paulfaget/PlasmaArcSpeaker/Images/Gap in operation.JPG

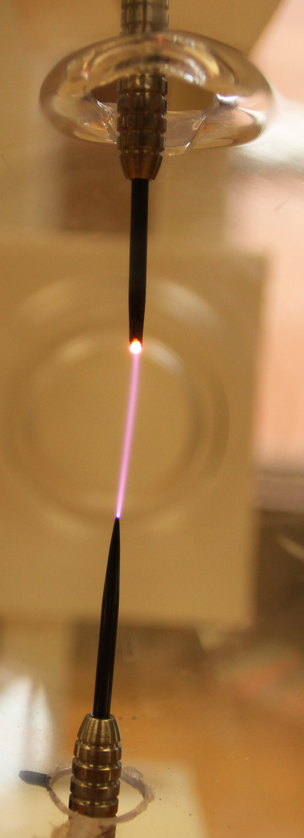
Images/Gap in operation.JPG
