paulfaget/PlasmaArcSpeaker/Images/Amplifier Innards_resized.jpg

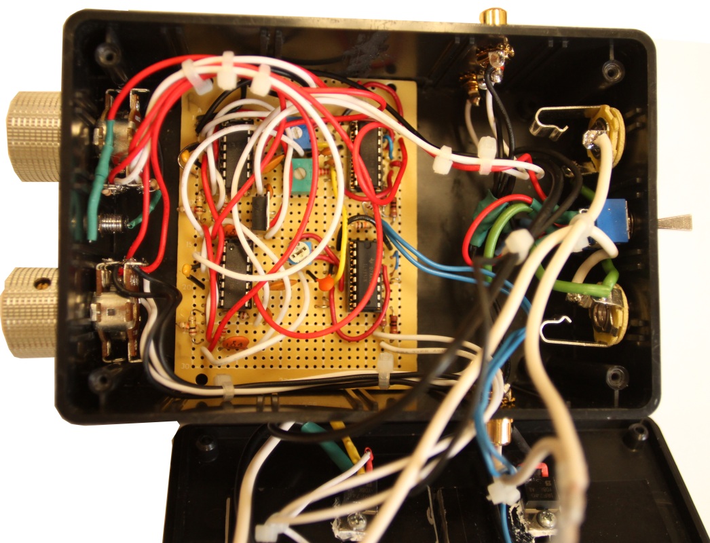
Images/Amplifier Innards_resized.jpg
