paulfaget/PlasmaArcSpeaker/Mechanical/pairwise (2).xlsx

Sheet: Work
PAS Pairwise Comparison
 |  | Safety | Operation Force (N) | Sound Level (dB) | Cost
CV 1 | Concept 1 | 2 | 15 | 65 | 75
CV 2 | Concept 2 | 4 | 15 | 80 | 80
CV 6 | Concept 3 | 1 | 10 | 60 | 60
CV 8 | Concept 4 | 4 | 5 | 65 | 70
Raw Score
 | Safety | Operation Force | Sound Level | Cost
Concept 1 | 0.333 | 0 | 0.25 | 0.75
Concept 2 | 1 | 0 | 1 | 0
Concept 3 | 0 | 0.5 | 0 | 1
Concept 4 | 1 | 1 | 0.25 | 0.5
Psuedo Variants
 | Sketch 1 | Sketch 2 | Sketch 3 | Sketch 4
Safety | 4 | 1 | 1 | 1
Operation Force (N) | 15 | 5 | 15 | 15
Sound Level (dB) | 60 | 60 | 80 | 60
Cost | 80 | 80 | 80 | 60
Pseudo 2 > 3 > 1 > 4
Comparing 2 and 3
Thus Psuedo 2 becomes A and Psuedo 3 becomes B
First equation will become Wsoundlvl = Y*Woperation force
Will increase A until both options A & B are equal. The value of A that makes A & B the same is 10 N.
Our x-axis values are 5, 10 and 15; |  | Our y-axis values are 0, Y, 1
After interpolation the equation becomes Wsoundlvl = 0.5*Woperation force
Comparing 3 and 1
The second equation will become Wsafety = Y*Wsoundlvl
Will decrease A until both options A & B are equal. The value of A that makes A & B the same is 70 dB.
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
