paulfaget/PlasmaArcSpeaker/Mechanical/Table.xlsx

Team PAS Plasma Arc Speaker Failure Modes
Failure Mode Primary Identifier | Failure Mode | Likelihood | Consequence Rating | Description
Creep | Stress Rupture | 3 | 5 | The arms holding the top and bottom electrodes could break in two as a result of stress from the electrode weight and temperature changes within the speaker housing.
Fatigue | Surface Fatigue | 3 | 4 | The rack and pinion used to raise and lower the electrodes could experience cyclical fatigue and fail over time.
Fretting | Thermal Fatigue | 1 | 4 | Temperature changes, ranging from hot when the speaker is on to cold when the speaker is off, could cause failure in the mechanical device used to raise and lower the electrodes.
Rupture | Brittle Fracture | 3 | 5 | The arms holding the top and bottom electrodes could break in two due to the electrode weight.
Spalling | Spalling | 1 | 3 | Particles could break loose in the rack and pinion housing, interupting the smooth operation of the rack and pinion.
Wear | Surface Fatigue Wear | 2 | 4 | Wear could cause failure in the rack and pinion, as well as more spalling.
Breakdown | Glow Discharge | 4 | 2 | Electrodes could heat up and glow, causing the metal to melt and/or vaporize.
Noise | Electric Field Coupling | 3 | 4 | Electric fields created by the high voltage of the plasma arc could cause interference with electrical devices.
Noise | Electromagnetic Radiation | 3 | 4 | The plasma arc operates at high frequencies, causing interference with electrical devices.
Noise | Ground Bounce | 1 | 2 | Poor ground connections could result in interference with electrical devices.
Overstress or Incorrect Current Magnitude | Electrical Overstress (EOS) | 2 | 2 | A higher current could be produced, creating more heat on the electrodes and raising the potential for the electrodes to melt and/or vaporize.
