paulfaget/PlasmaArcSpeaker/Mechanical/Concept Sketches.pdf

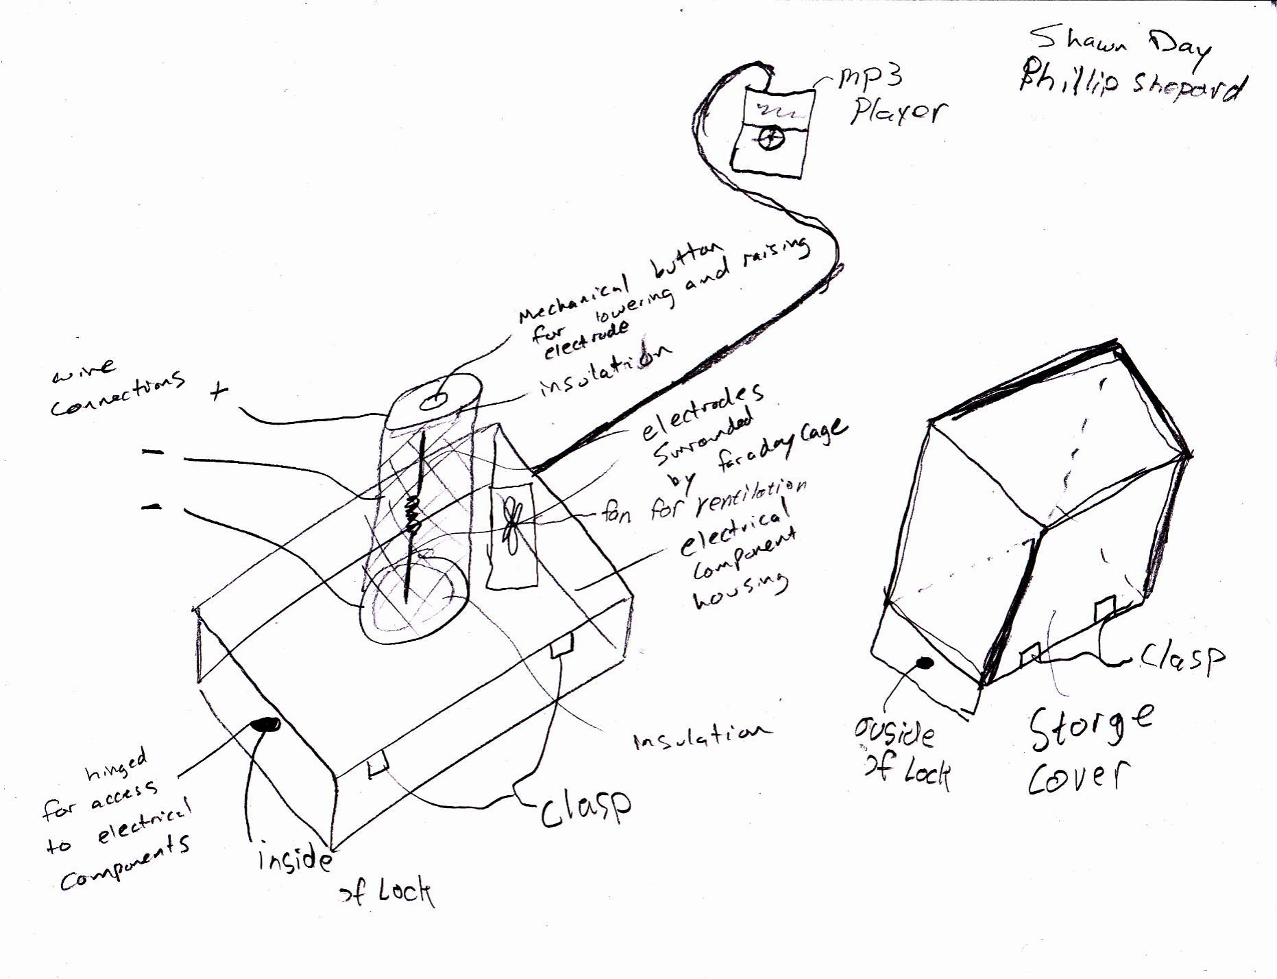
[picture p13: page 1]

IhP3
PLror

Sho-^ f;o.,
9A,l+'p sl,"p!,r/

'. .*sr r.i
-, -\ 'l o^t
g:cts^',lrre' '"1
W-

vts J ' t

\,.9,tq+iaA
V', *5'A
.c.
P6 o&'.)rJ
+e e\cu'.nl s
C""qn' | ir,qide\
7{ Loc\

6\aSp

# gin'K,**

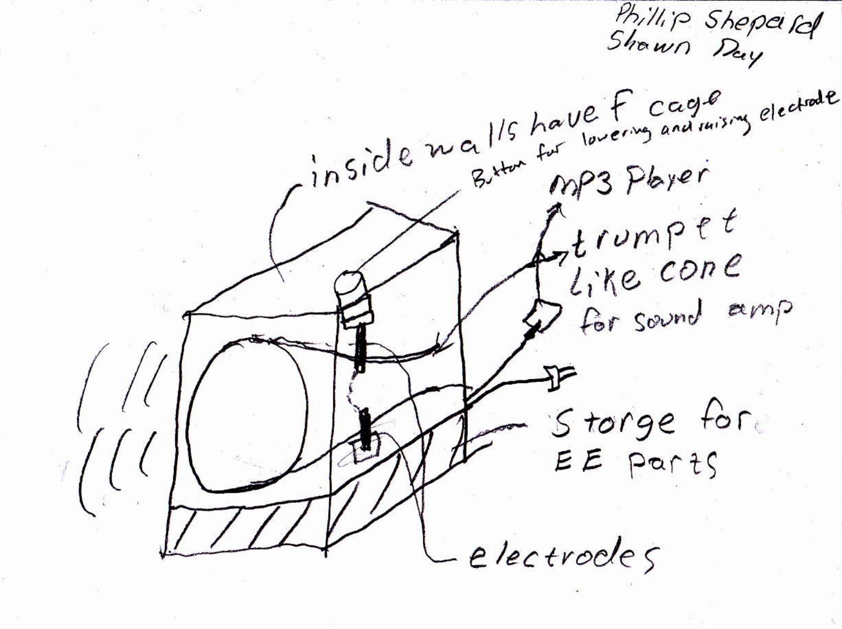
[picture p14: page 2]

e ( c*?o.,^ epcr')a
r .,'cl u * ^-l',i-Yu?*)';;*"'"' V
wwnW3 PbYn' in5'
+ t,trnP (

t
i;rru ,r,
e
&r se,roJ on{)

[//
'(t

,

g turge A r,
E E portg

g lec+roe)e
g

# ffi^nYr

c;;e#"'

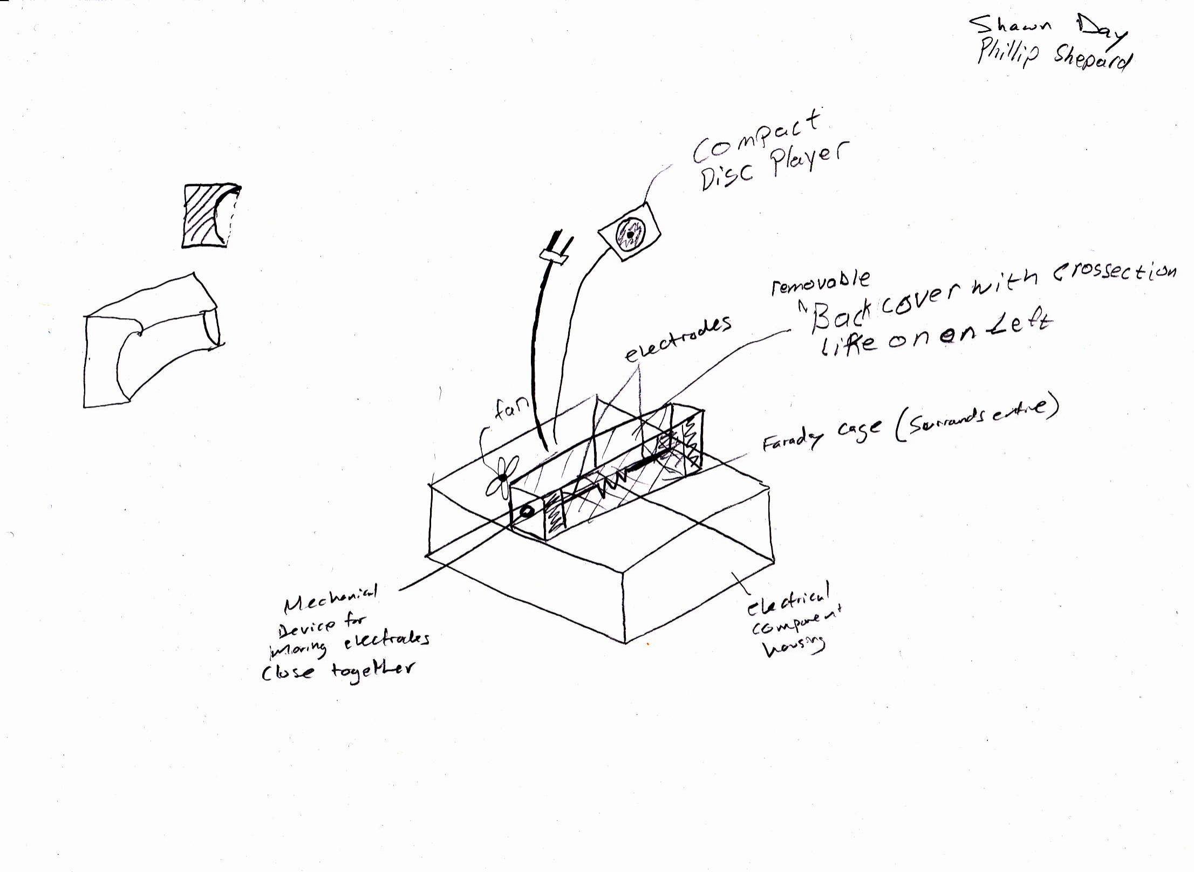
[picture p15: page 3]

l) etv'n:nl ''
tr::;7"+*'

# WI;'*"1!", \i{"'J' an te!*

## r"-)Y ^5' (9"-)'"*c)

## 'rYI:\

rc(evoEle

\A*t)

, p4 ( loskc t i,tu

Clos-e' \el4+r

## ll;/t;p shepa rel

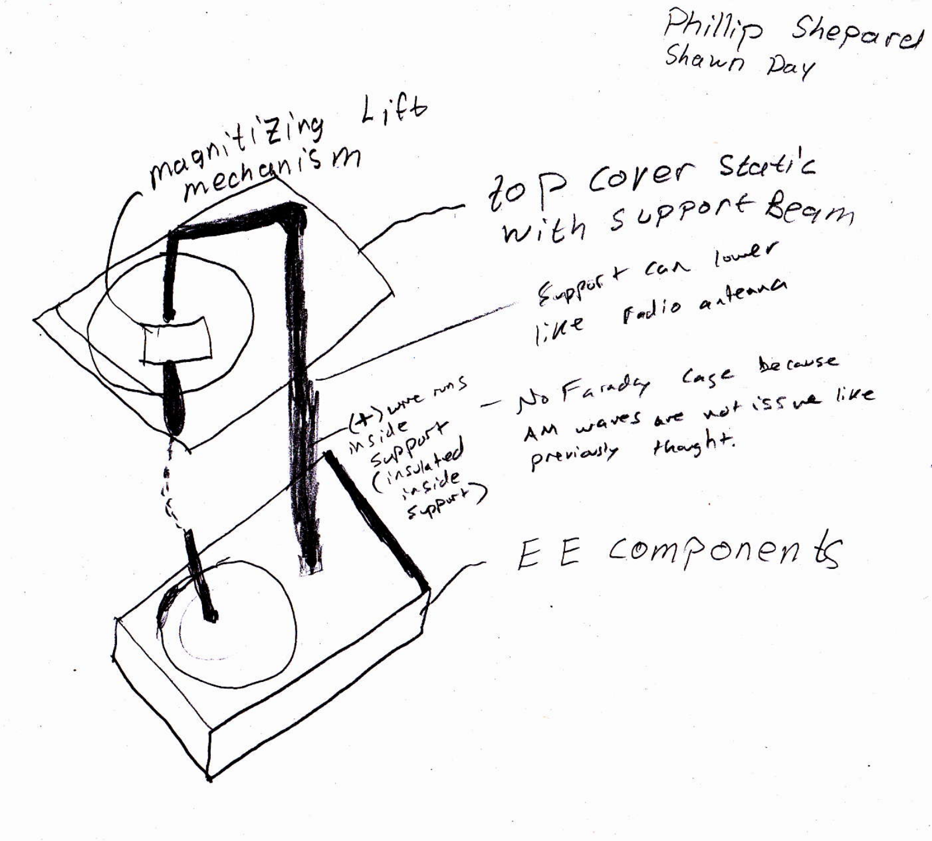
[picture p16: page 4]

>aau,p *ry
L iQb .+ i7 in9 {}ri'* | Cofet^ Stalr2 toP S uP?Dr( E€q*,

### w ith

(;:.

""^')

b,..2/
,.N*o

*)o (o'-l?
I r.rr *ra Jf,J
g *viatlt/

ttga
ae #l
rn*\*.

6c t"us<'
is< r^t lilc

a
c
(\
E E .om?onen k
