paulfaget/PlasmaArcSpeaker/Mechanical/Decision_Matrix_Example.xls

Sheet: Template_DM
PAS Decision Matrix
 | How important are these evaluation criteria? |  |  |  | How good are these concepts?
 | 5: Extremely Important |  |  |  | 5: Very Good
 | 4: Very Important |  |  |  | 4: Good
 | 3: Important |  |  |  | 3: Moderate
 | 2: Moderately Important |  |  |  | 2: Satisfactory
 | 1: Least Important |  |  |  | 1: Acceptable
 | 0: Not Important |  |  |  | 0: Out of concern
 | Objective | Target Value | Importance |  | CV 1 (Figure 1) |  | CV 2 (Figure 2) |  | CV3 (Figure 3) |  | CV4 (Figure 4) |  | CV5 (Figure 5) |  | CV6 (Figure 6) |  | CV7 (Figure 7) |  | CV8 (Figure 8) |  | CV9 (Figure 9) |  | CV10 (Figure 10)
 | (Criteria) |  | (Weight) |  | Raw | Weighted | Raw | Weighted | Raw | Weighted | Raw | Weighted | Raw | Weighted | Raw | Weighted | Raw | Weighted | Raw | Weighted | Raw | Weighted | Raw | Weighted
 | Safe | No Able to be Shocked | 5 | 29.41176471% | 3 | 0.88 | 4 | 1.18 | 1 | 0.29 | 3 | 0.88 | 2 | 0.59 | 4 | 1.18 | 4 | 1.18 | 4 | 1.18 | 1 | 0.29 | 4 | 1.18
 | Easily Operated | Separate Electrodes up to 1.5" | 4 | 23.52941176% | 4 | 0.94 | 4 | 0.94 | 3 | 0.71 | 3 | 0.71 | 0 | 0.00 | 4 | 0.94 | 3 | 0.71 | 5 | 1.18 | 0 | 0.00 | 5 | 1.18
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
