paulfaget/PlasmaArcSpeaker/Images/Power Supply innards_resized.jpg

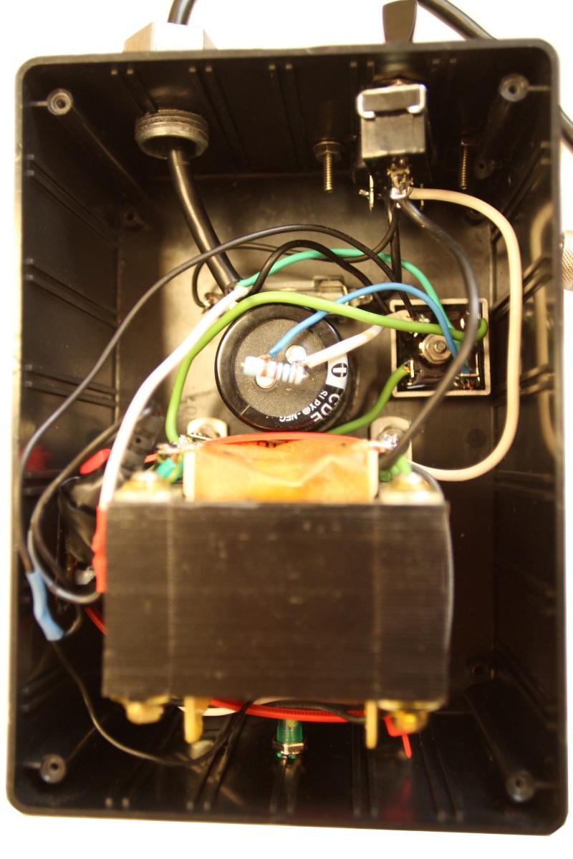
Images/Power Supply innards_resized.jpg
