paulfaget/PlasmaArcSpeaker/Schematics and Drawings/Crossover/Crossover BW.png

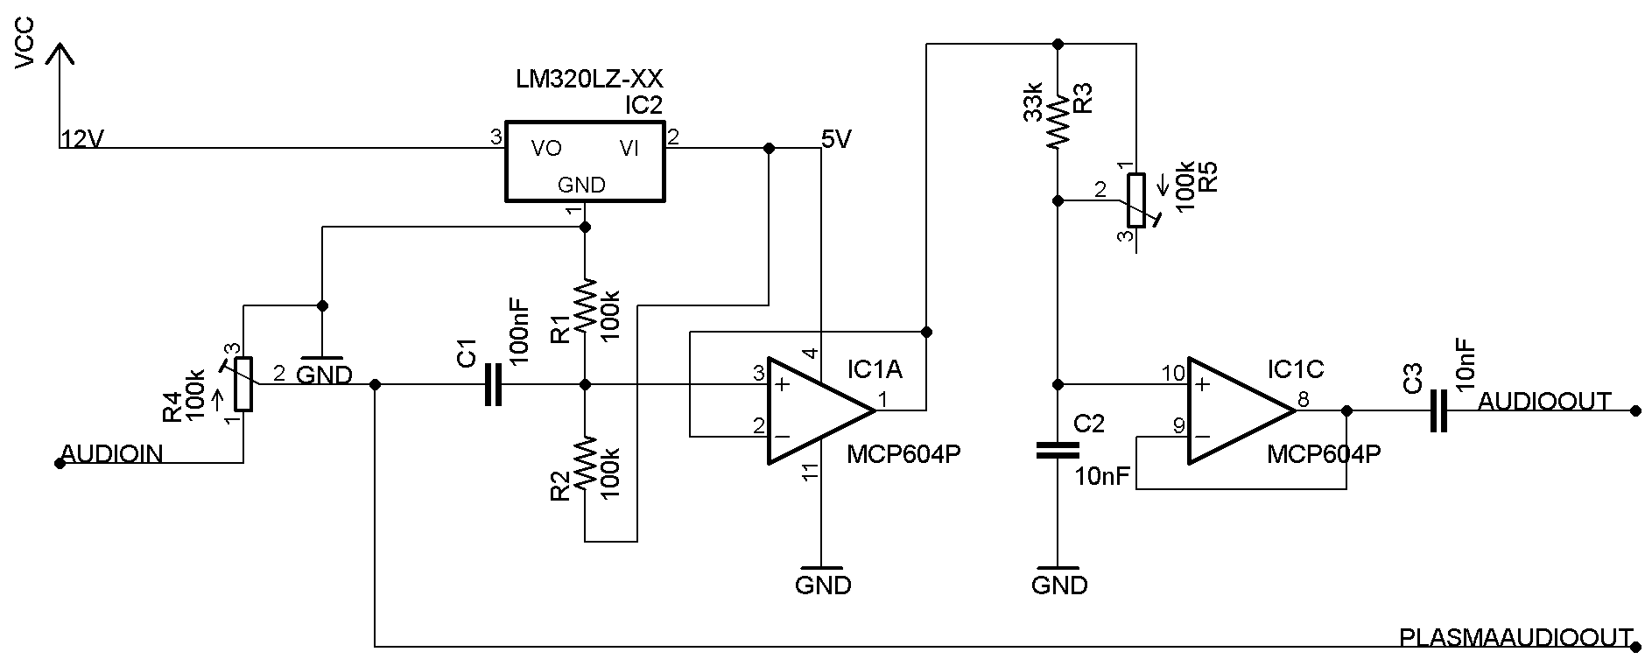
Schematics and Drawings/Crossover/Crossover BW.png
