paulfaget/PlasmaArcSpeaker/Schematics and Drawings/Crossover/Crossover.png

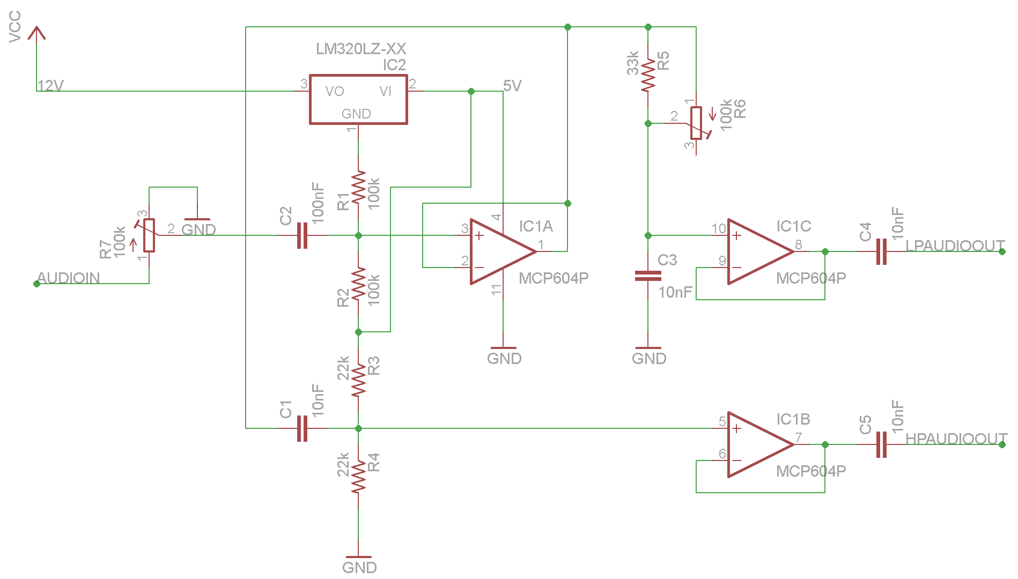
Schematics and Drawings/Crossover/Crossover.png
