paulfaget/PlasmaArcSpeaker/Schematics and Drawings/Mechanical/3D View.tif

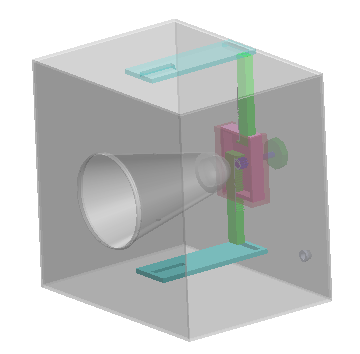
Schematics and Drawings/Mechanical/3D View.tif
