paulfaget/PlasmaArcSpeaker/Schematics and Drawings/Mechanical/Back View.tif

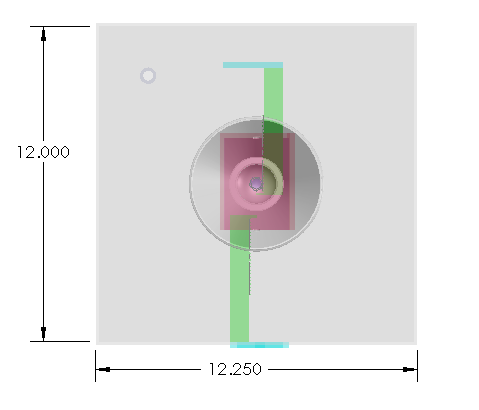
Schematics and Drawings/Mechanical/Back View.tif
