paulfaget/PlasmaArcSpeaker/Schematics and Drawings/Power Supply/Power Supply BW.png

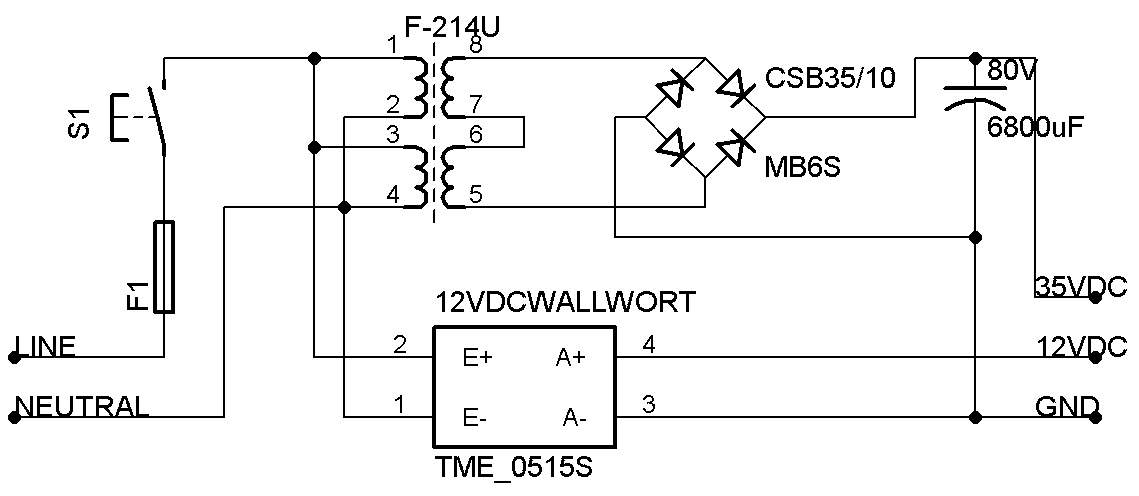
Schematics and Drawings/Power Supply/Power Supply BW.png
