paulfaget/PlasmaArcSpeaker/Schematics and Drawings/SDS/Rev1/SDS Block Diagram, Plasma Generator rev1.png

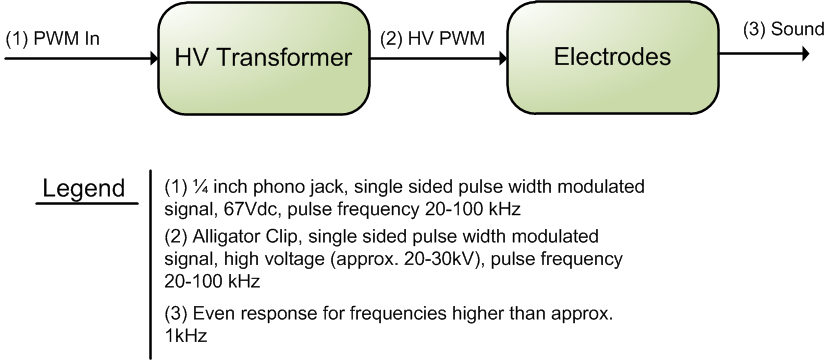
Schematics and Drawings/SDS/Rev1/SDS Block Diagram, Plasma Generator rev1.png
