paulfaget/PlasmaArcSpeaker/Schematics and Drawings/SDS/Rev1/SDS Block Diagram, Power Supply rev1.png

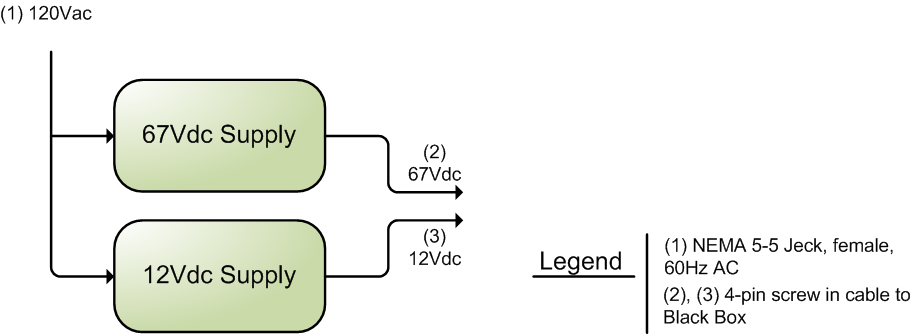
Schematics and Drawings/SDS/Rev1/SDS Block Diagram, Power Supply rev1.png
