paulfaget/PlasmaArcSpeaker/Schematics and Drawings/SDS/Rev1/SDS Block Diagram, Signal Processor rev1.png

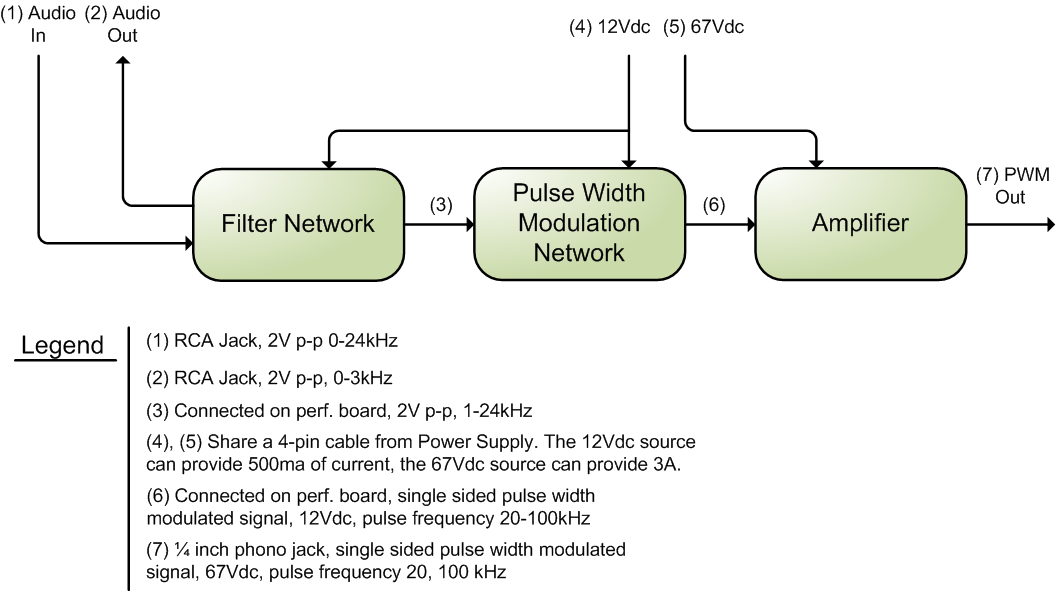
Schematics and Drawings/SDS/Rev1/SDS Block Diagram, Signal Processor rev1.png
