paulfaget/PlasmaArcSpeaker/Schematics and Drawings/SDS/Rev1/SDS Block Diagram, Whole System rev1.png

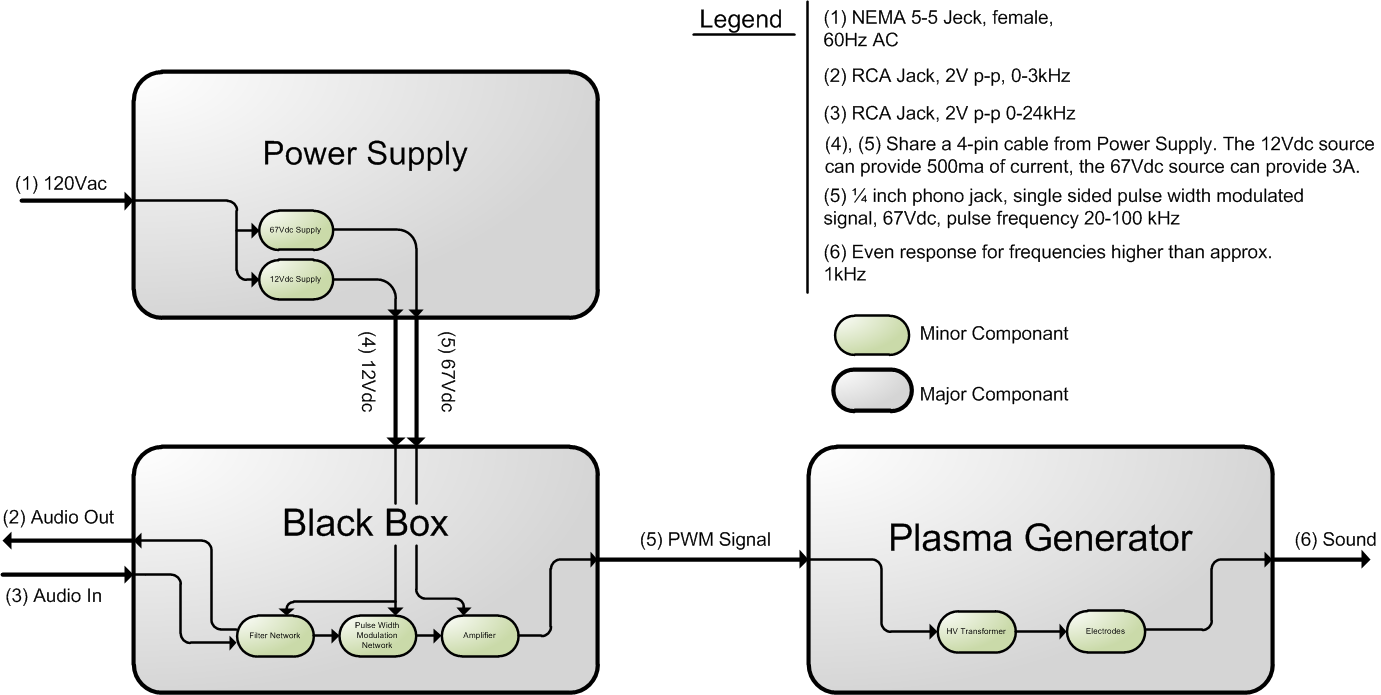
Schematics and Drawings/SDS/Rev1/SDS Block Diagram, Whole System rev1.png
