paulfaget/PlasmaArcSpeaker/Schematics and Drawings/SDS/SDS Block Diagram, Plasma Generator rev2.png

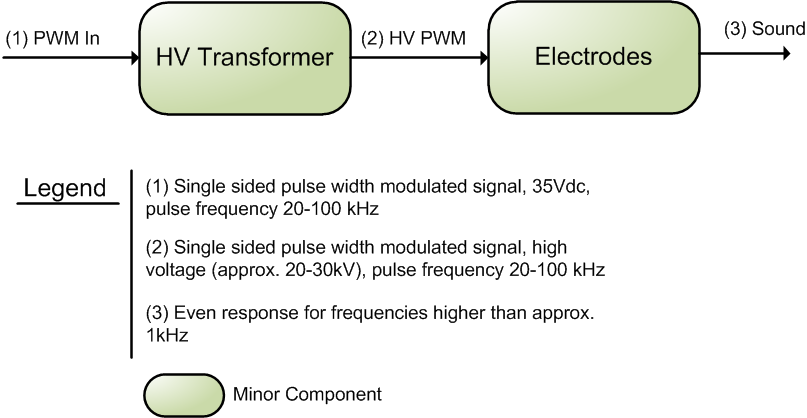
Schematics and Drawings/SDS/SDS Block Diagram, Plasma Generator rev2.png
