paulfaget/PlasmaArcSpeaker/Schematics and Drawings/SDS/SDS Block Diagram, Power Supply rev2.png

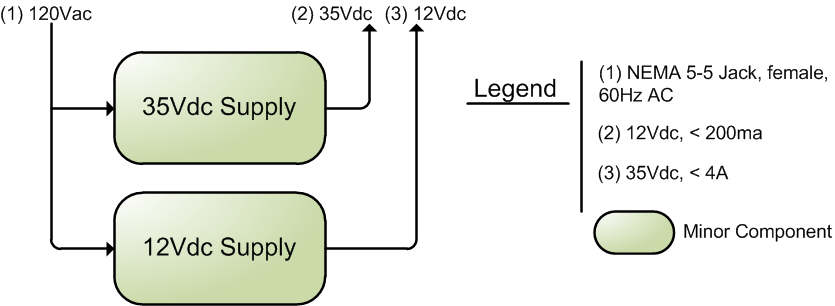
Schematics and Drawings/SDS/SDS Block Diagram, Power Supply rev2.png
