paulfaget/PlasmaArcSpeaker/Schematics and Drawings/SDS/SDS Block Diagram, Singal Processor rev2.png

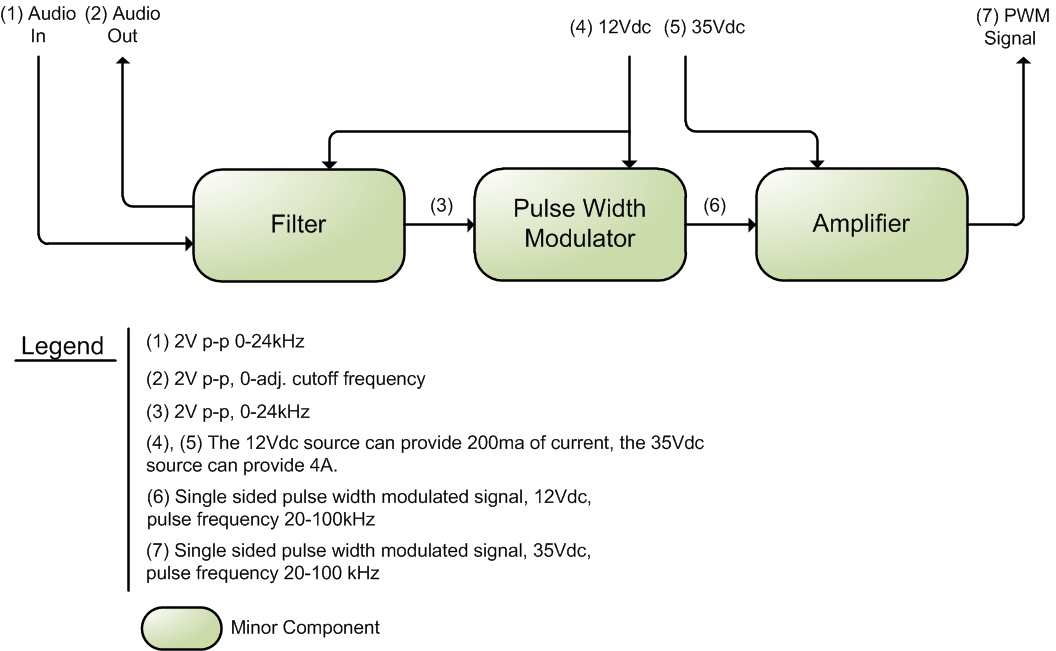
Schematics and Drawings/SDS/SDS Block Diagram, Singal Processor rev2.png
