paulfaget/PlasmaArcSpeaker/Schematics and Drawings/SDS/SDS Block Diagram, Whole System rev2.png

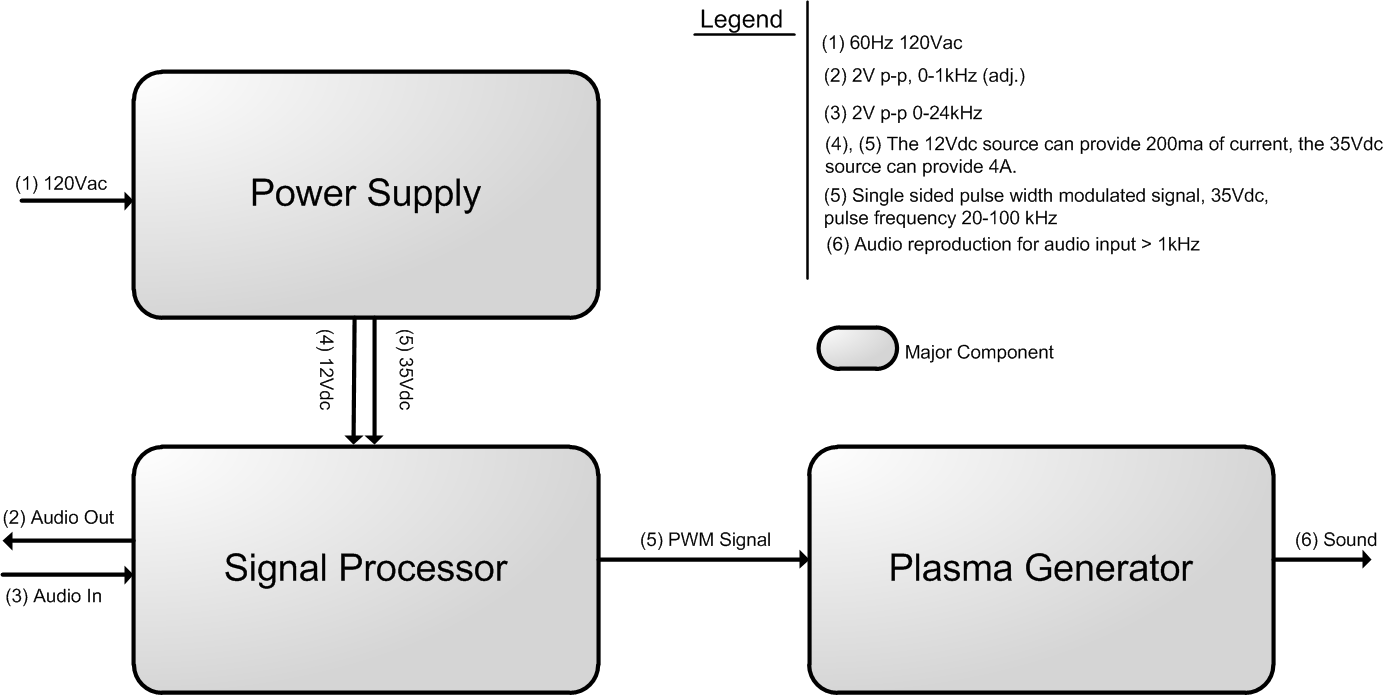
Schematics and Drawings/SDS/SDS Block Diagram, Whole System rev2.png
