paulfaget/PlasmaArcSpeaker/Schematics and Drawings/SDS/SDS Block Diagram, Whole System rev2a.png

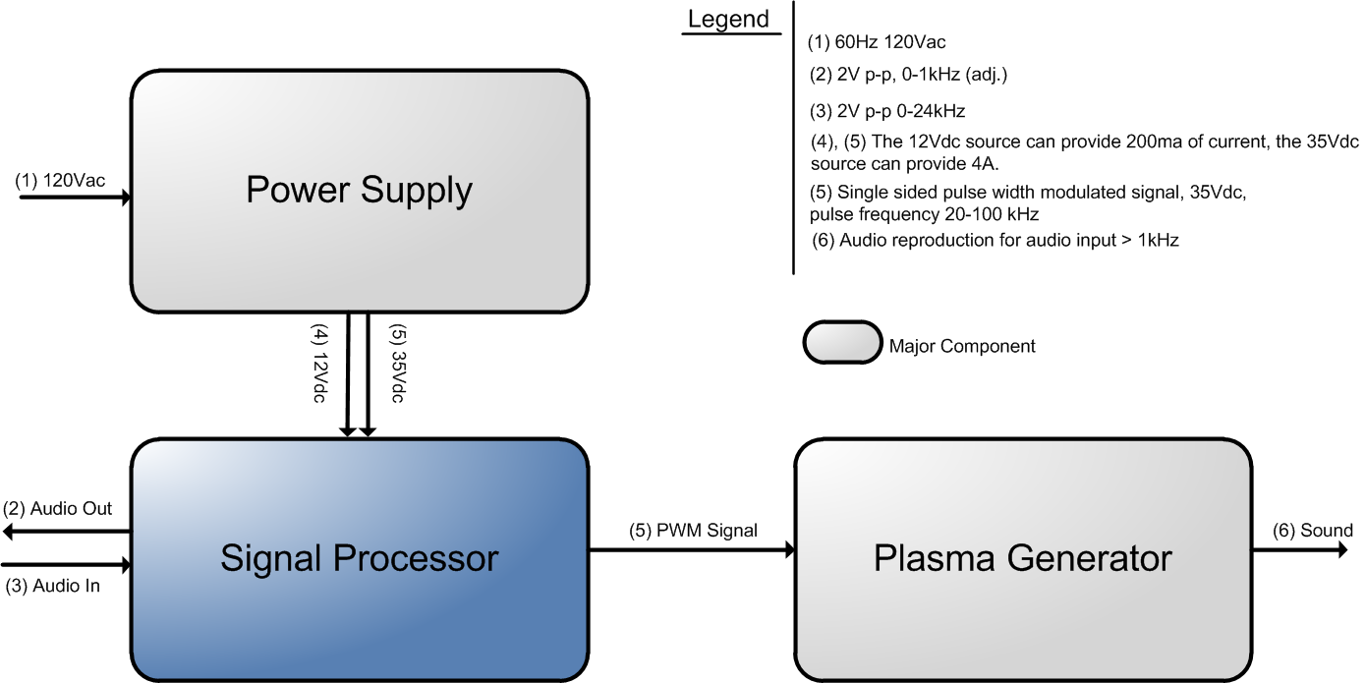
Schematics and Drawings/SDS/SDS Block Diagram, Whole System rev2a.png
