paulfaget/PlasmaArcSpeaker/Schematics and Drawings/Stereo Driver/Driver - Bridge Only BW.png

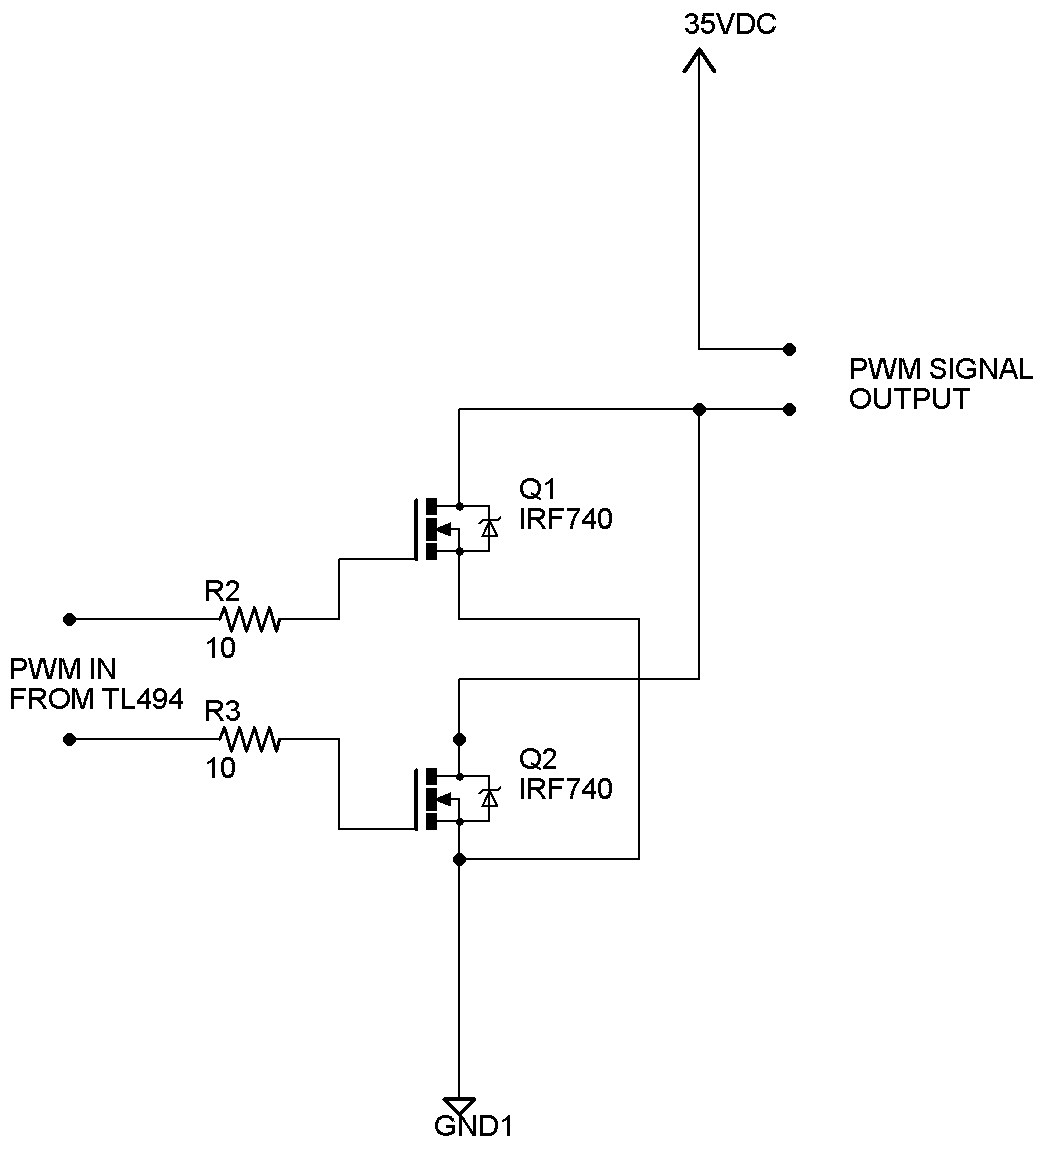
Schematics and Drawings/Stereo Driver/Driver - Bridge Only BW.png
