paulfaget/PlasmaArcSpeaker/Schematics and Drawings/Stereo Driver/Driver - Driver Only BW.png

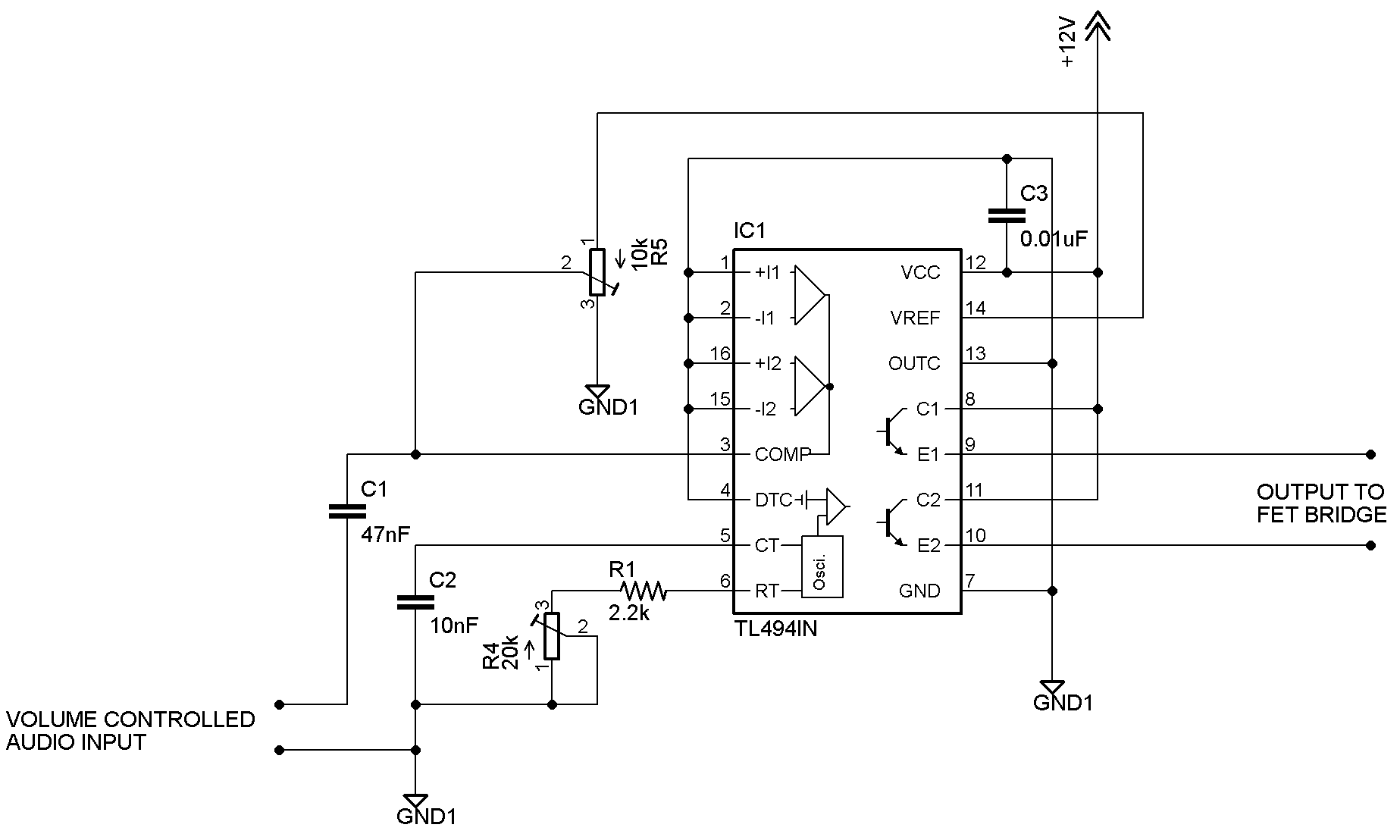
Schematics and Drawings/Stereo Driver/Driver - Driver Only BW.png
