paulfaget/PlasmaArcSpeaker/Schematics and Drawings/Stereo Driver/Driver - Single Channel BW.png

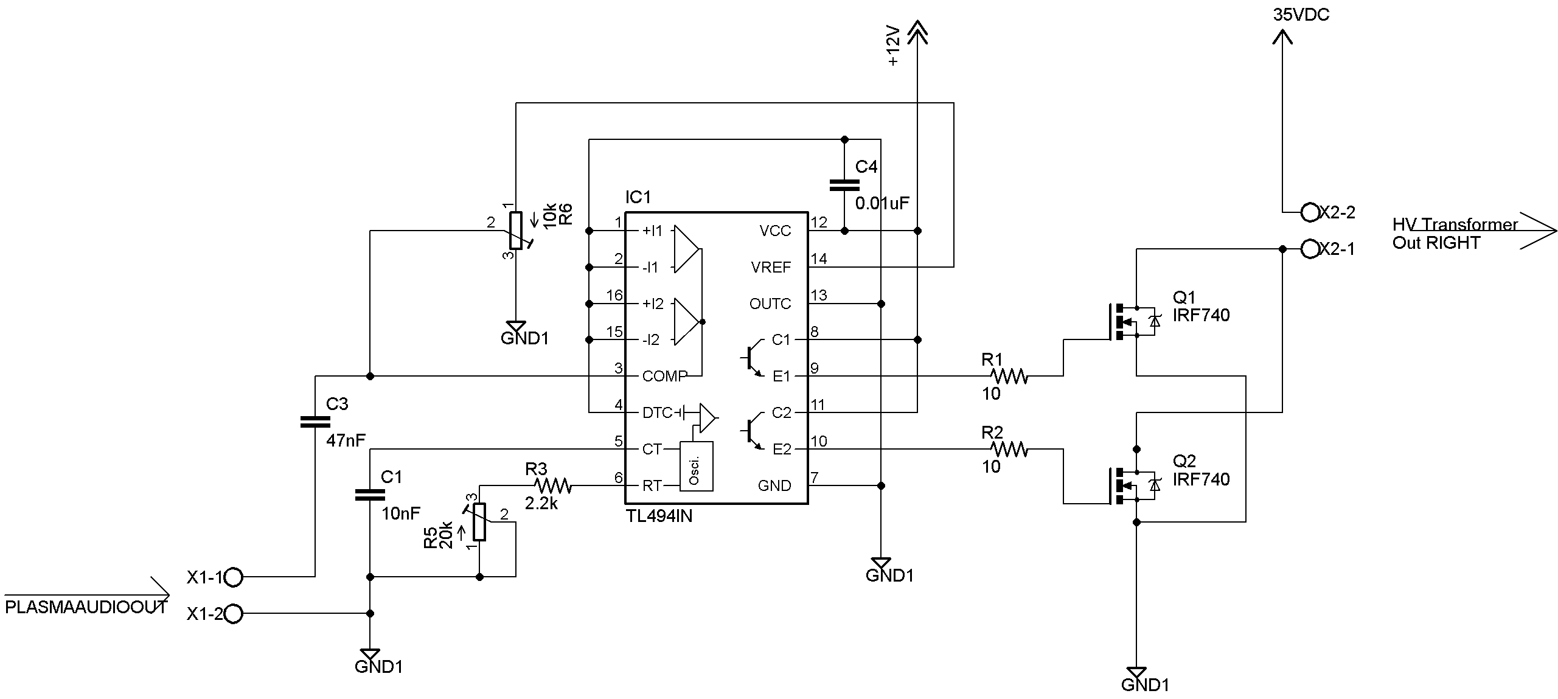
Schematics and Drawings/Stereo Driver/Driver - Single Channel BW.png
