paulfaget/PlasmaArcSpeaker/Schematics and Drawings/Stereo Driver/Driver - Single Channel.png

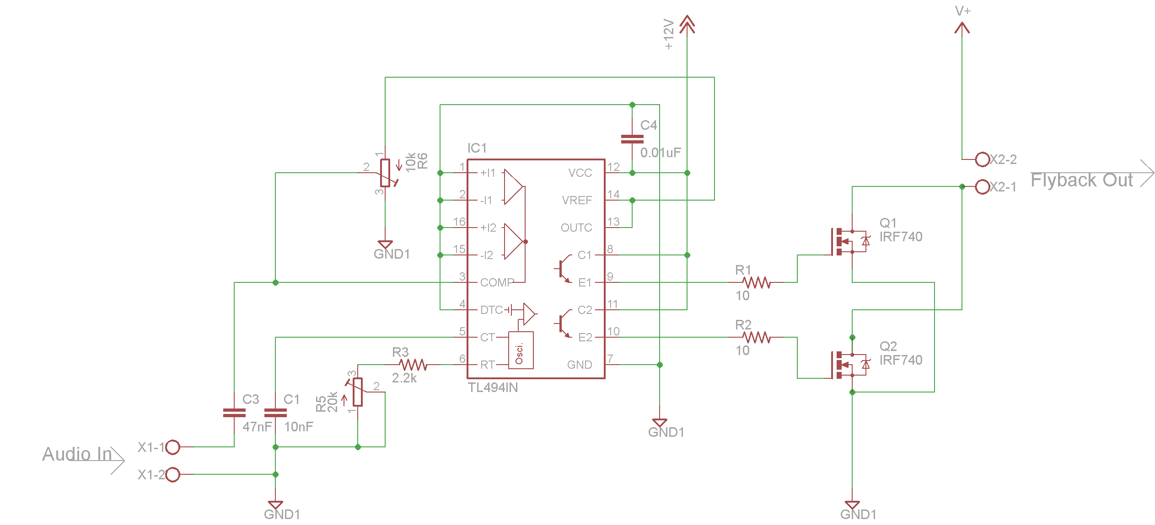
Schematics and Drawings/Stereo Driver/Driver - Single Channel.png
