paulfaget/PlasmaArcSpeaker/Schematics and Drawings/Stereo Driver/Driver - Stereo BW.png

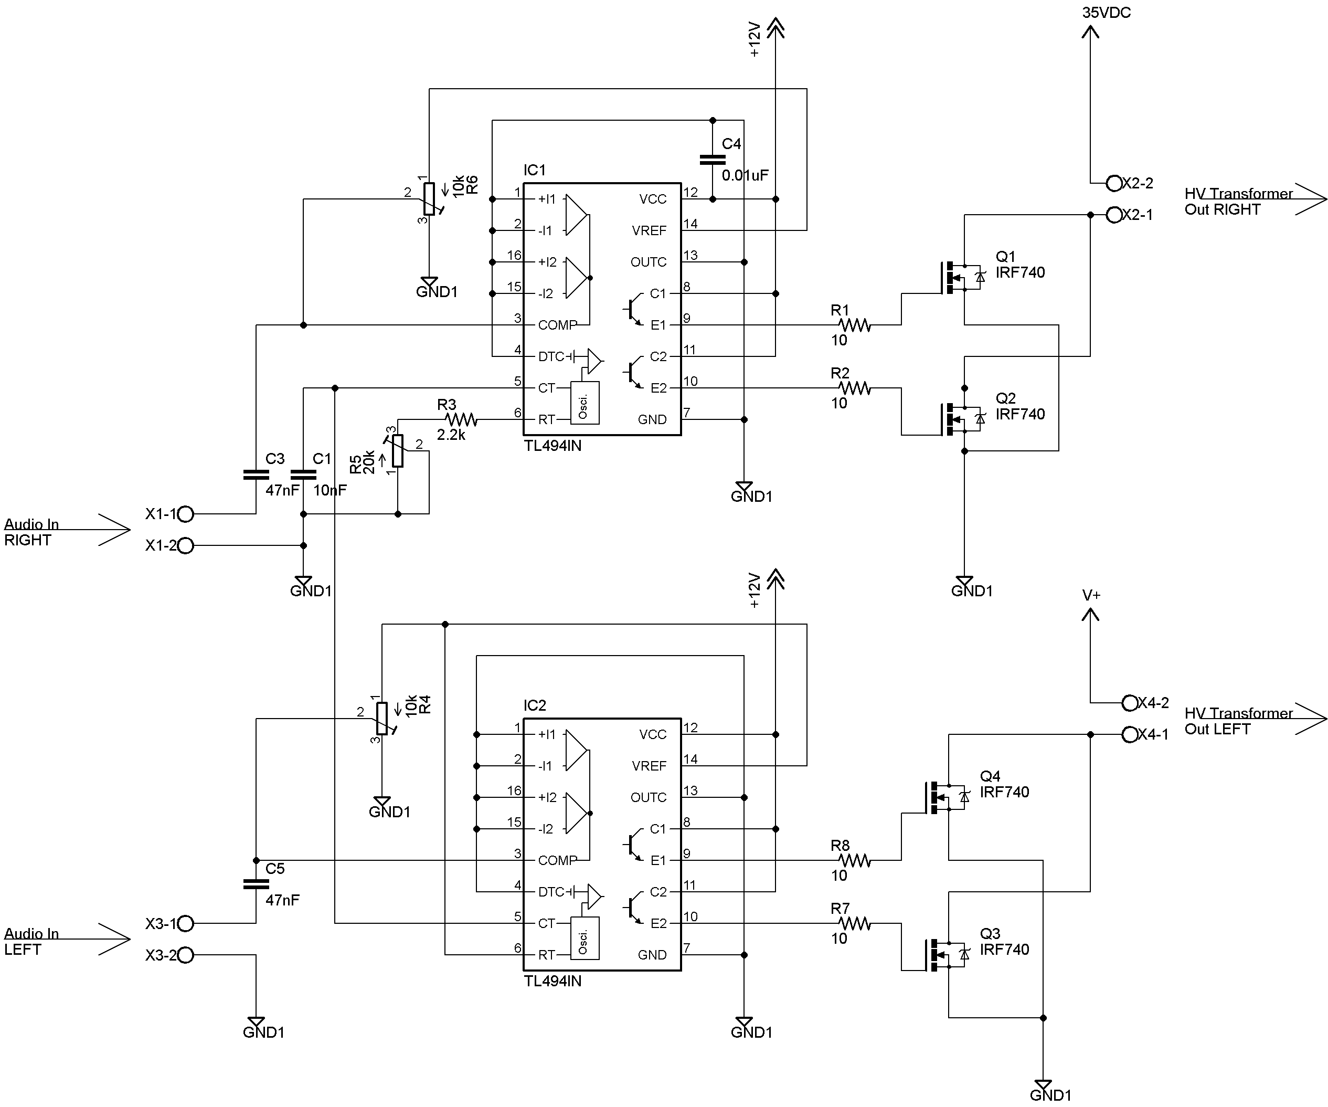
Schematics and Drawings/Stereo Driver/Driver - Stereo BW.png
