paulfaget/PlasmaArcSpeaker/Schematics and Drawings/Stereo Driver/Driver Amplifier.png

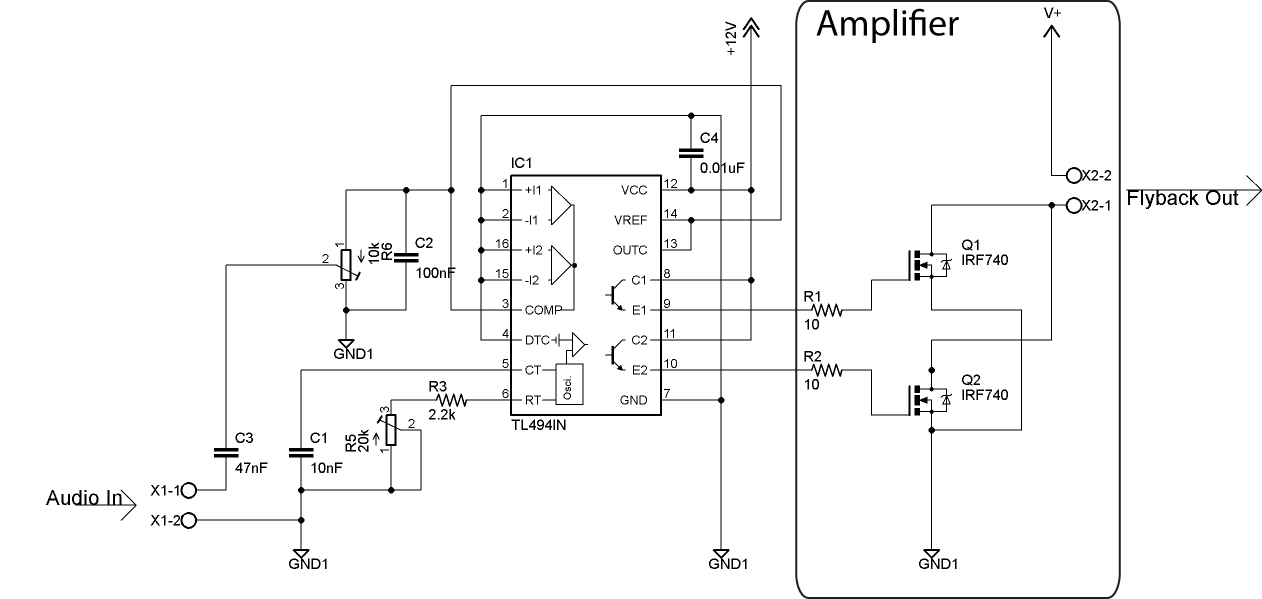
Schematics and Drawings/Stereo Driver/Driver Amplifier.png
