paulfaget/PlasmaArcSpeaker/Schematics and Drawings/Stereo Driver/Driver PWM.png

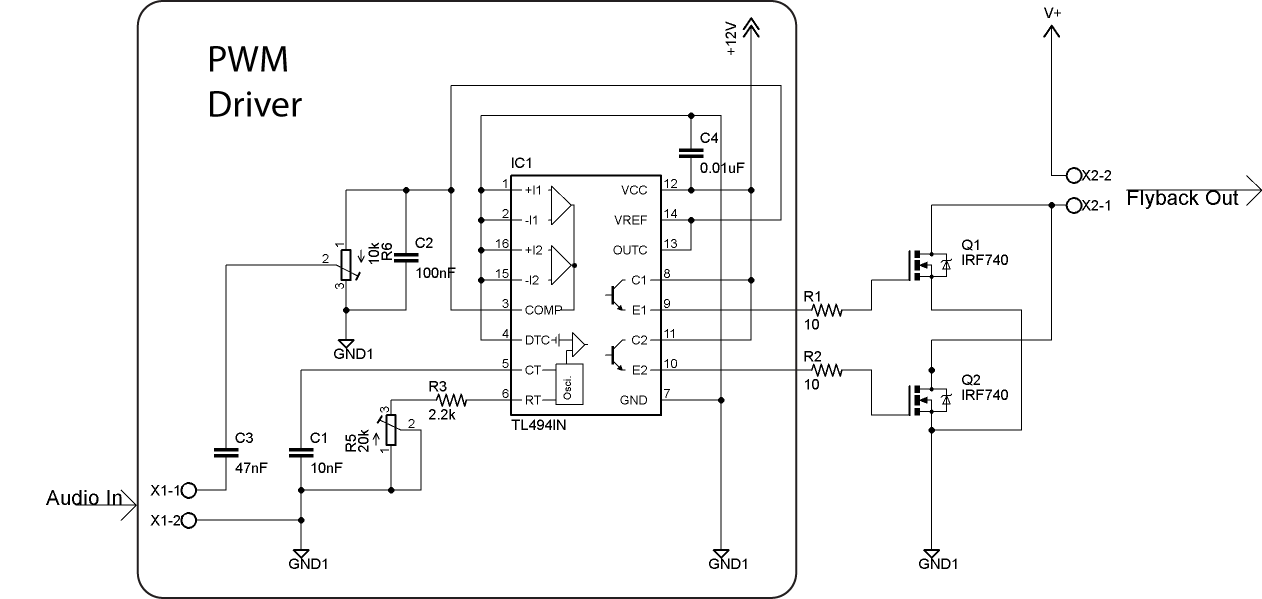
Schematics and Drawings/Stereo Driver/Driver PWM.png
