paulfaget/PlasmaArcSpeaker/Schematics and Drawings/Stereo Driver/Driver.png

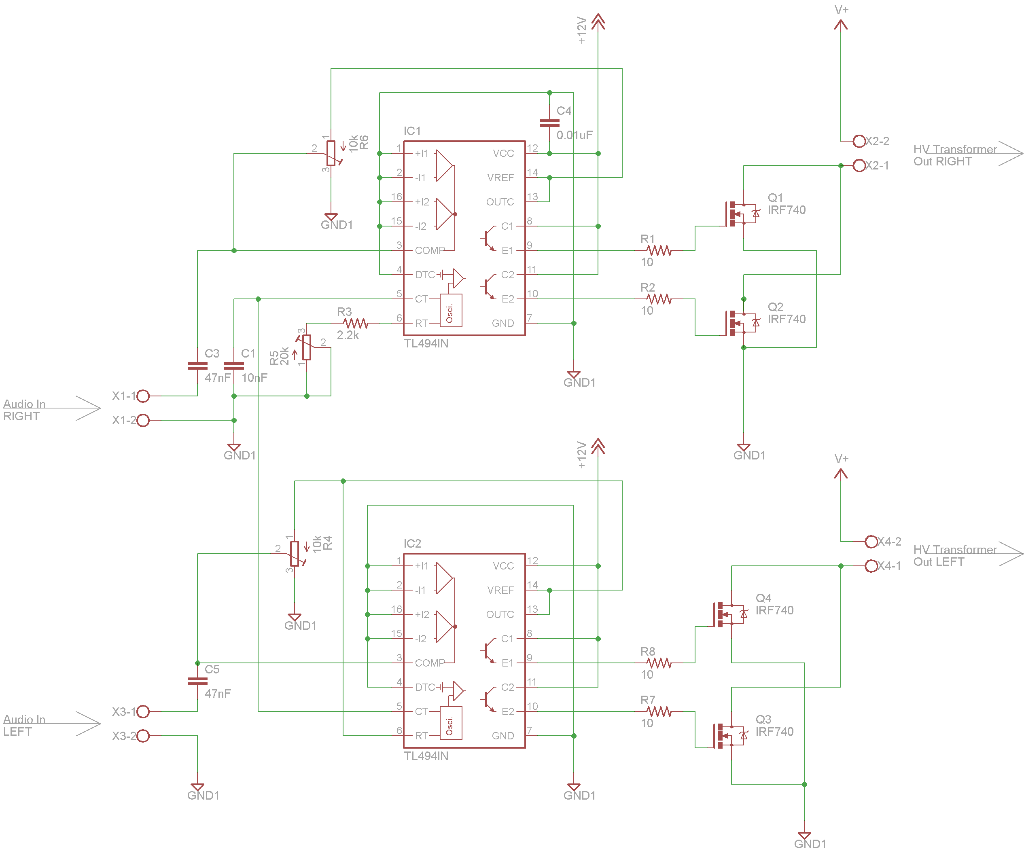
Schematics and Drawings/Stereo Driver/Driver.png
