paulfaget/PlasmaArcSpeaker/Mechanical/ME Solid Works Stuff/Full Assembly.SLDASM

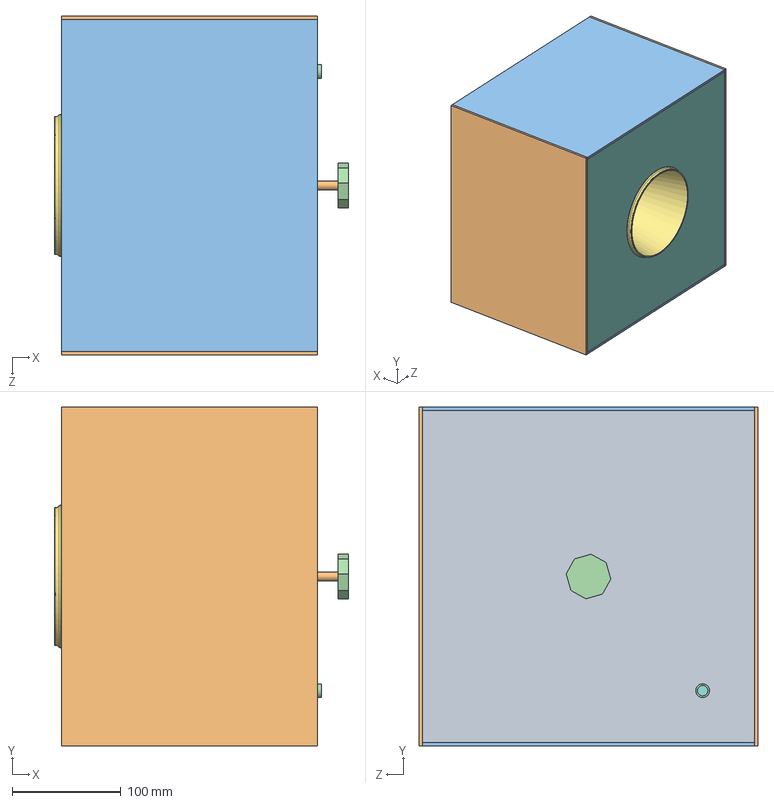
[picture p40: CAD file, 2012-08-12]
Mechanical/ME Solid Works Stuff/Full Assembly.SLDASM
270.0 x 311.2 x 311.1 mm
Gear Housing 1
Inch - Spur gear
Inch - Rack-spur - rectangular x 2
knob
Gear Housing 2
Electrode Arm x 2
Front cover
Back cover
Top Bottom x 2
Side x 2
input
Electrode x 2
Bolt x 2
Washer x 8
Nut x 4
