paulfaget/PlasmaArcSpeaker/Mechanical/ME Solid Works Stuff/IGES Files Generic 3D Files/Inch - Spur gear.IGS

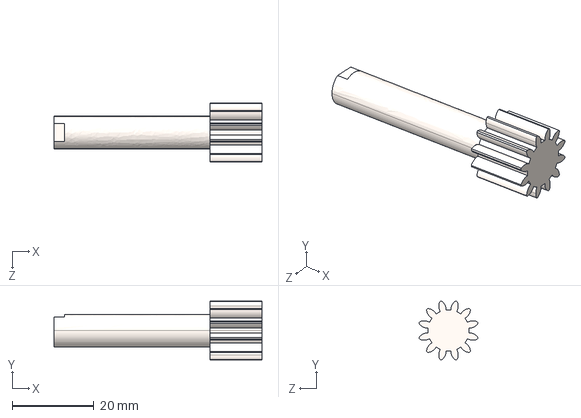
[picture p41: CAD file, 2012-08-12]
Mechanical/ME Solid Works Stuff/IGES Files Generic 3D Files/Inch - Spur gear.IGS
50.8 x 14.4 x 14.4 mm
