paulfaget/PlasmaArcSpeaker/Mechanical/ME Solid Works Stuff/Side.SLDPRT

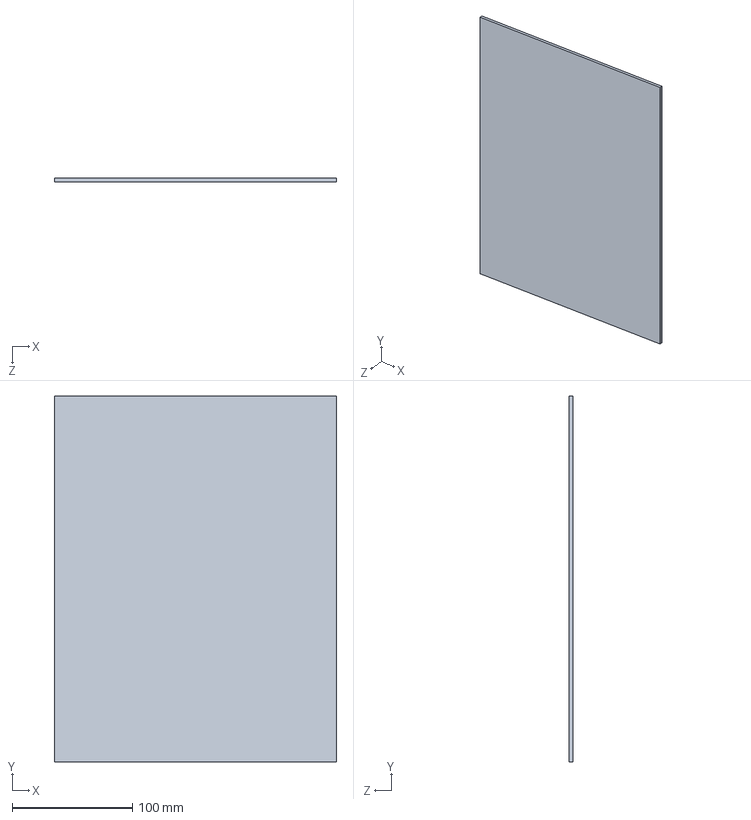
[picture p42: CAD file, 2012-08-12]
Mechanical/ME Solid Works Stuff/Side.SLDPRT
235.0 x 304.8 x 3.17 mm
