paulfaget/PlasmaArcSpeaker/Mechanical/ME Solid Works Stuff/Gear Housing 2.SLDPRT

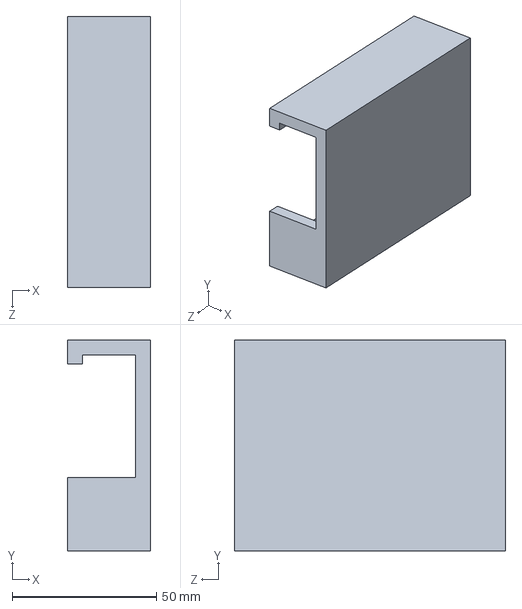
[picture p43: CAD file, 2012-08-12]
Mechanical/ME Solid Works Stuff/Gear Housing 2.SLDPRT
28.6 x 73.0 x 94.0 mm
