paulfaget/PlasmaArcSpeaker/Mechanical/ME Solid Works Stuff/IGES Files Generic 3D Files/Inch - Rack-spur - rectangular.IGS

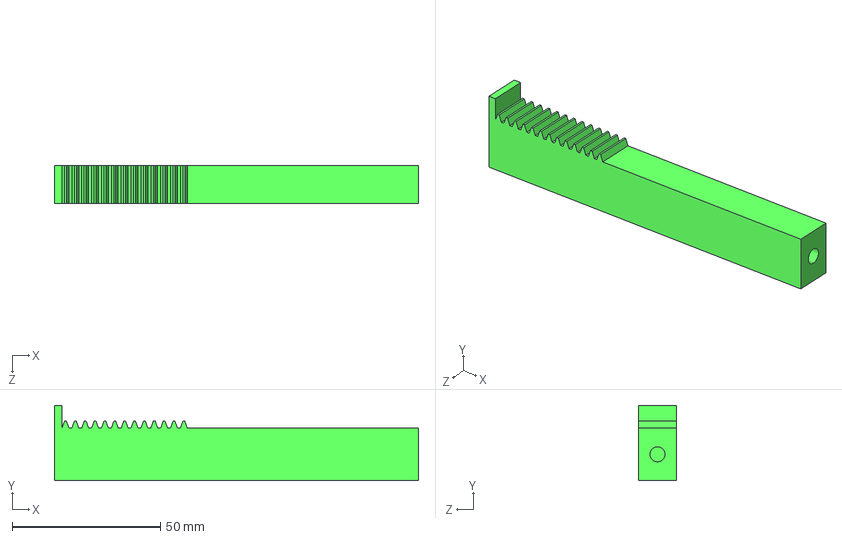
[picture p44: CAD file, 2012-08-12]
Mechanical/ME Solid Works Stuff/IGES Files Generic 3D Files/Inch - Rack-spur - rectangular.IGS
122.7 x 25.4 x 12.7 mm
