paulfaget/PlasmaArcSpeaker/Mechanical/ME Solid Works Stuff/STL Files (Gear stuff For RPC)/knob.STL

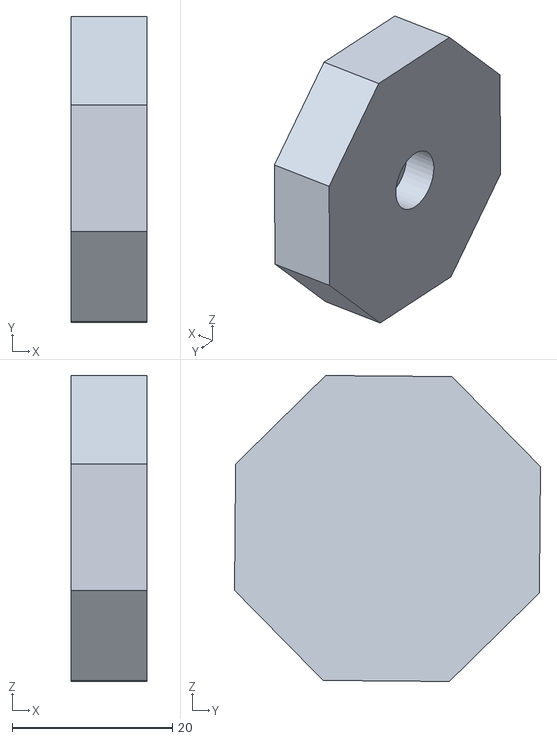
[picture p45: CAD file, 2012-08-12]
Mechanical/ME Solid Works Stuff/STL Files (Gear stuff For RPC)/knob.STL
9.53 x 38.2 x 38.2
