paulfaget/PlasmaArcSpeaker/Mechanical/ME Solid Works Stuff/Electrode Arm.SLDPRT

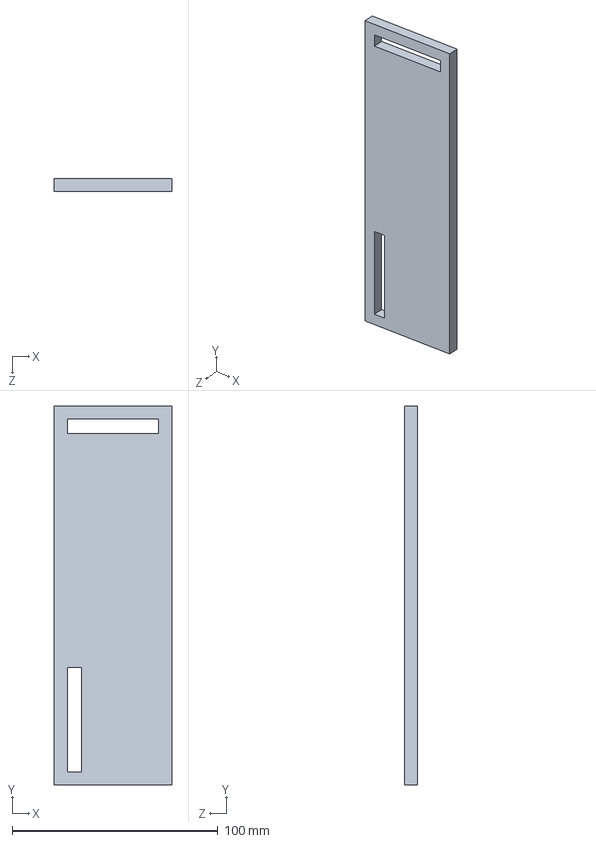
[picture p46: CAD file, 2012-08-12]
Mechanical/ME Solid Works Stuff/Electrode Arm.SLDPRT
57.1 x 184.1 x 6.35 mm
