paulfaget/PlasmaArcSpeaker/Mechanical/ME Solid Works Stuff/IGES Files Generic 3D Files/Electrode.IGS

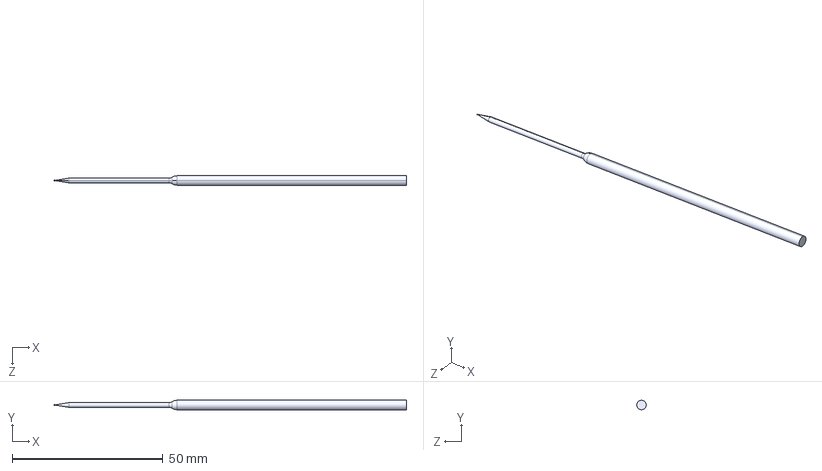
[picture p47: CAD file, 2012-08-12]
Mechanical/ME Solid Works Stuff/IGES Files Generic 3D Files/Electrode.IGS
116.9 x 3.18 x 3.17 mm
