paulfaget/PlasmaArcSpeaker/Mechanical/ME Solid Works Stuff/IGES Files Generic 3D Files/Cone.IGS

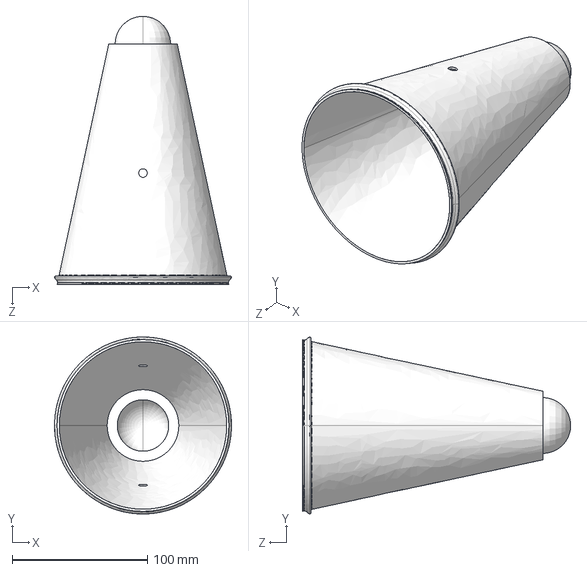
[picture p48: CAD file, 2012-08-12]
Mechanical/ME Solid Works Stuff/IGES Files Generic 3D Files/Cone.IGS
130.9 x 130.9 x 198.4 mm
