paulfaget/PlasmaArcSpeaker/Mechanical/ME Solid Works Stuff/Back cover.SLDPRT

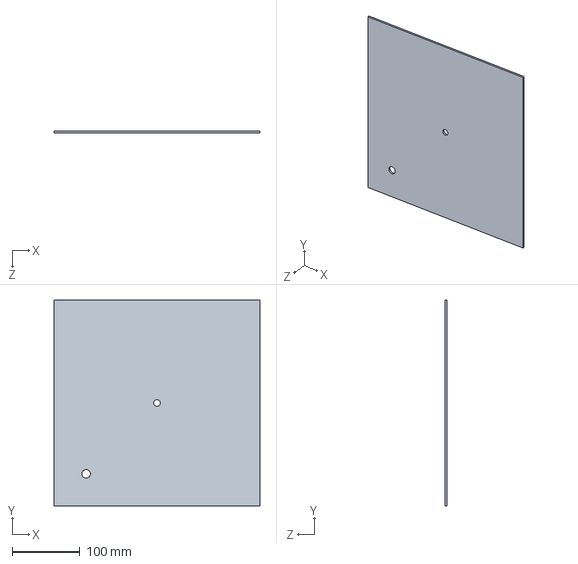
[picture p49: CAD file, 2012-08-12]
Mechanical/ME Solid Works Stuff/Back cover.SLDPRT
304.8 x 304.8 x 3.17 mm
