paulfaget/PlasmaArcSpeaker/Mechanical/ME Solid Works Stuff/IGES Files Generic 3D Files/Front cover.IGS

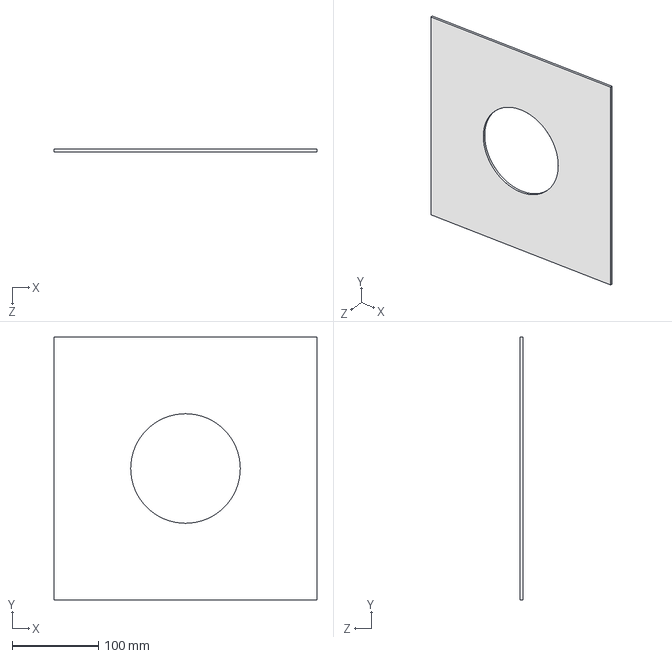
[picture p50: CAD file, 2012-08-12]
Mechanical/ME Solid Works Stuff/IGES Files Generic 3D Files/Front cover.IGS
304.8 x 304.8 x 3.17 mm
