paulfaget/PlasmaArcSpeaker/Mechanical/ME Solid Works Stuff/Top Bottom.SLDPRT

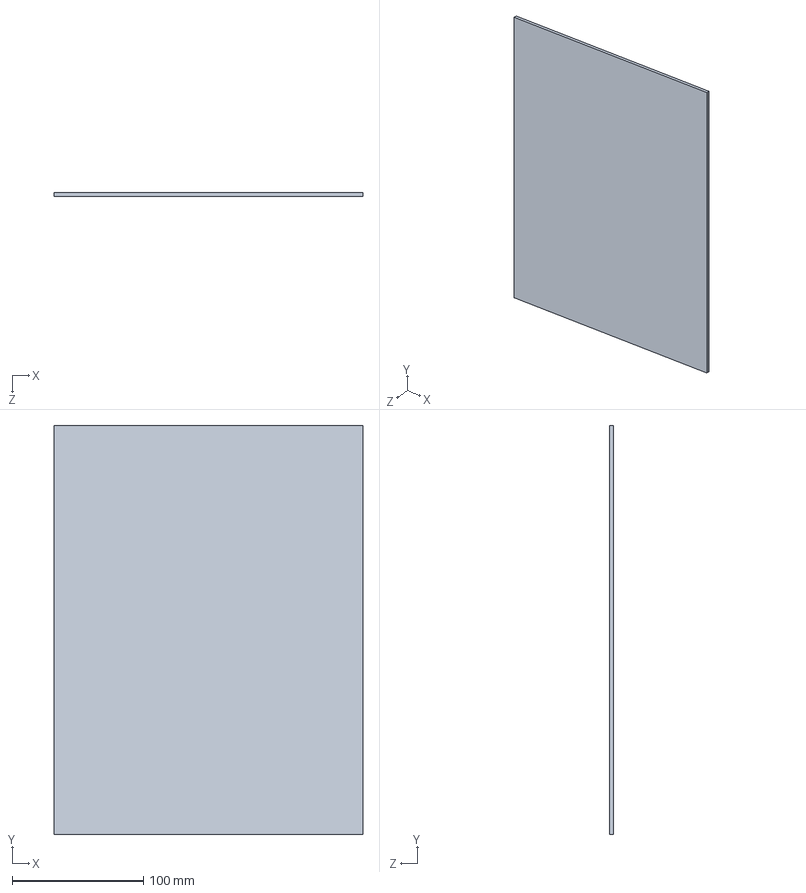
[picture p51: CAD file, 2012-08-12]
Mechanical/ME Solid Works Stuff/Top Bottom.SLDPRT
235.0 x 311.2 x 3.17 mm
