paulfaget/PlasmaArcSpeaker/Mechanical/ME Solid Works Stuff/STL Files (Gear stuff For RPC)/Gear Housing 1.STL

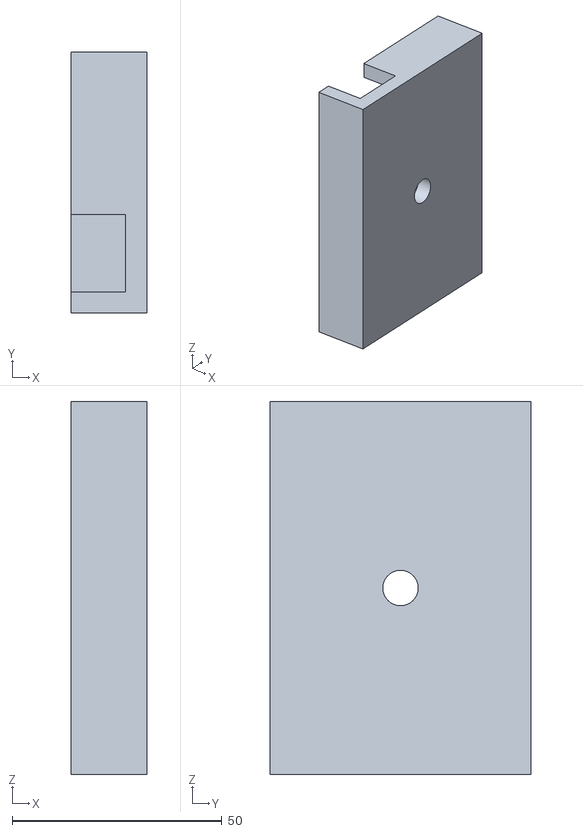
[picture p52: CAD file, 2012-08-12]
Mechanical/ME Solid Works Stuff/STL Files (Gear stuff For RPC)/Gear Housing 1.STL
18.0 x 62.3 x 88.9
