paulfaget/PlasmaArcSpeaker/Mechanical/ME Solid Works Stuff/input.SLDPRT

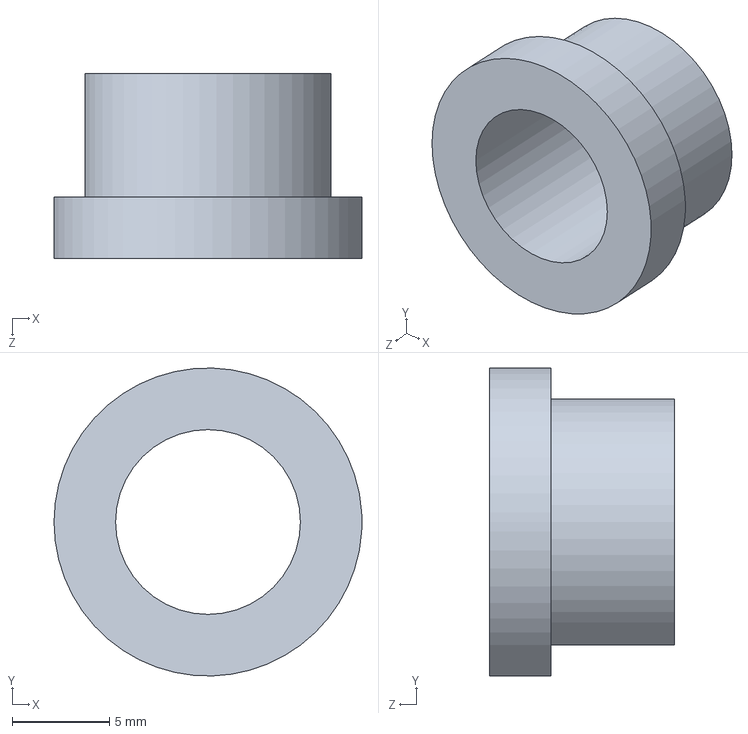
[picture p53: CAD file, 2012-08-12]
Mechanical/ME Solid Works Stuff/input.SLDPRT
15.9 x 15.9 x 9.53 mm
