paulfaget/PlasmaArcSpeaker/Mechanical/ME Solid Works Stuff/Electrode.SLDPRT

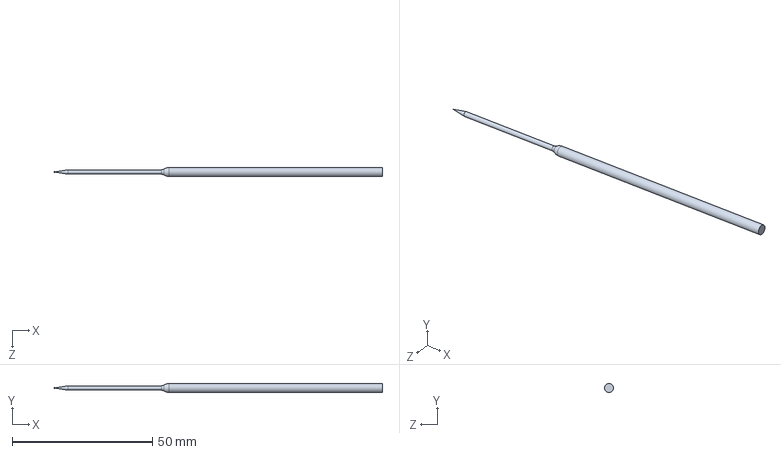
[picture p54: CAD file, 2012-08-12]
Mechanical/ME Solid Works Stuff/Electrode.SLDPRT
116.9 x 3.17 x 3.17 mm
