paulfaget/PlasmaArcSpeaker/(list of files, cad)

Other CAD files:
Mechanical/ME Solid Works Stuff/STL Files (Gear stuff For RPC)/Electrode Arm.STL
Mechanical/ME Solid Works Stuff/Inch - Rack-spur - rectangular.sldprt
Mechanical/ME Solid Works Stuff/STL Files (Gear stuff For RPC)/Gear Housing 2.STL
Mechanical/ME Solid Works Stuff/IGES Files Generic 3D Files/Gear Housing 2.IGS
Mechanical/ME Solid Works Stuff/STL Files (Gear stuff For RPC)/Inch - Rack-spur - rectangular.STL
Mechanical/ME Solid Works Stuff/STL Files (Gear stuff For RPC)/Inch - Spur gear.STL
Mechanical/ME Solid Works Stuff/IGES Files Generic 3D Files/Side.IGS
Mechanical/ME Solid Works Stuff/IGES Files Generic 3D Files/Back cover.IGS
Mechanical/ME Solid Works Stuff/Inch - Spur gear.sldprt
Mechanical/ME Solid Works Stuff/IGES Files Generic 3D Files/input.IGS
Mechanical/ME Solid Works Stuff/IGES Files Generic 3D Files/Top Bottom.IGS
Mechanical/ME Solid Works Stuff/Knob.SLDPRT
Mechanical/ME Solid Works Stuff/Front cover.SLDPRT
Mechanical/ME Solid Works Stuff/IGES Files Generic 3D Files/Knob.IGS
Mechanical/ME Solid Works Stuff/IGES Files Generic 3D Files/Electrode Arm.IGS
Mechanical/ME Solid Works Stuff/Cone.SLDPRT
Mechanical/ME Solid Works Stuff/IGES Files Generic 3D Files/Gear Housing 1.IGS
Mechanical/ME Solid Works Stuff/Gear Housing 1.SLDPRT
Mechanical/ME Solid Works Stuff/Bolt.SLDPRT
Mechanical/ME Solid Works Stuff/IGES Files Generic 3D Files/Bolt.IGS
Mechanical/ME Solid Works Stuff/IGES Files Generic 3D Files/Nut.IGS
Mechanical/ME Solid Works Stuff/IGES Files Generic 3D Files/Washer.IGS
Mechanical/ME Solid Works Stuff/Nut.SLDPRT
Mechanical/ME Solid Works Stuff/STL Files (Gear stuff For RPC)/Electrode Arm - Copy.STL
Mechanical/ME Solid Works Stuff/STL Files (Gear stuff For RPC)/Inch - Rack-spur - rectangular - Copy.STL
Mechanical/ME Solid Works Stuff/Washer.SLDPRT
