paulfaget/PlasmaArcSpeaker/Schematics and Drawings/Mechanical/Full Assembly.TIF

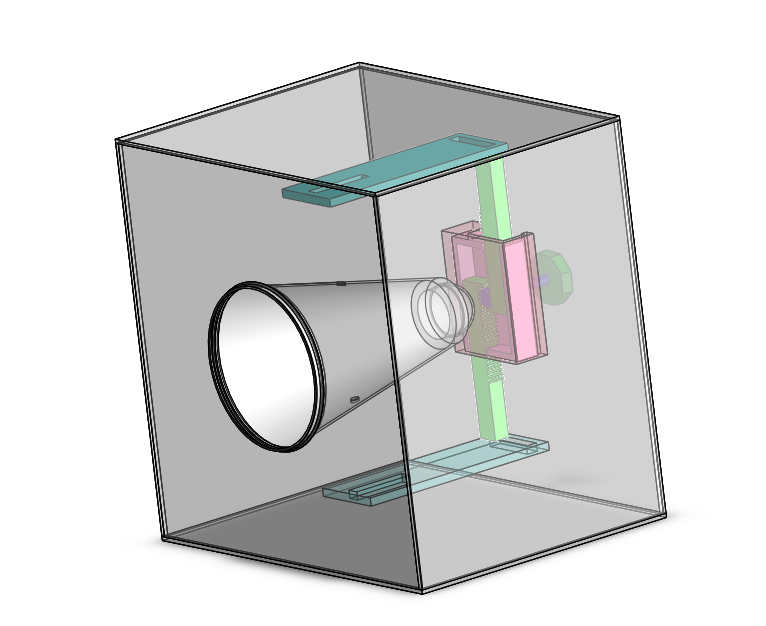
Schematics and Drawings/Mechanical/Full Assembly.TIF
