paulfaget/PlasmaArcSpeaker/Test Results/PRINT_07.BMP

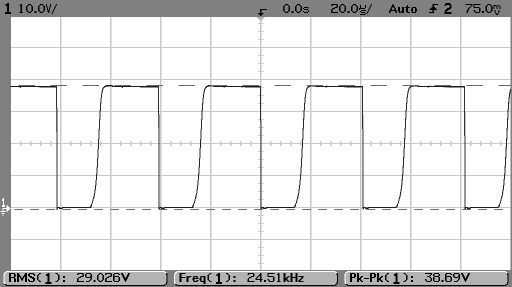
Test Results/PRINT_07.BMP
