paulfaget/PlasmaArcSpeaker/Test Results/PRINT_07.png

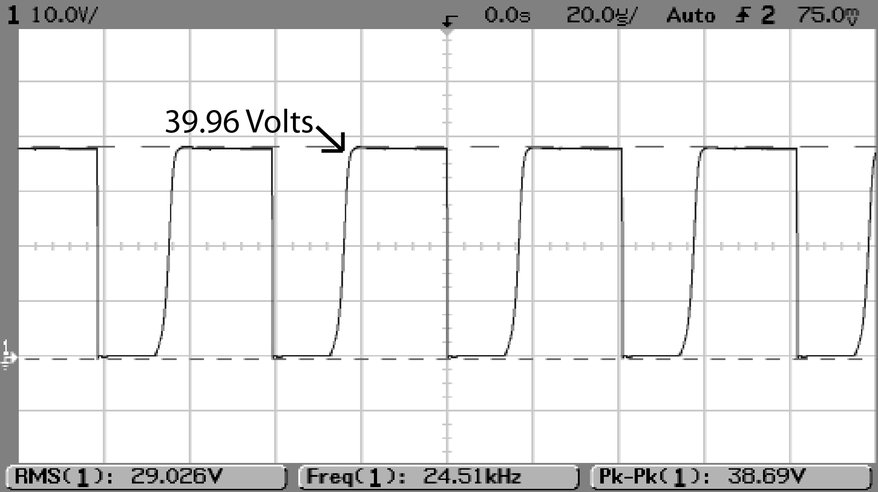
Test Results/PRINT_07.png
