paulfaget/PlasmaArcSpeaker/Test Results/whitenoise-event-Shrunk.png

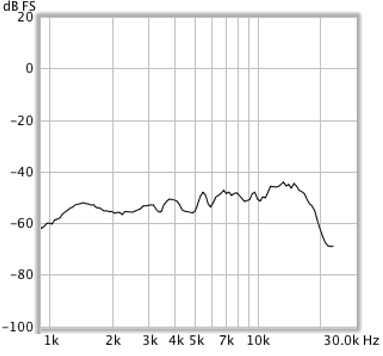
Test Results/whitenoise-event-Shrunk.png
