paulfaget/PlasmaArcSpeaker/Test Results/whitenoise-event.png

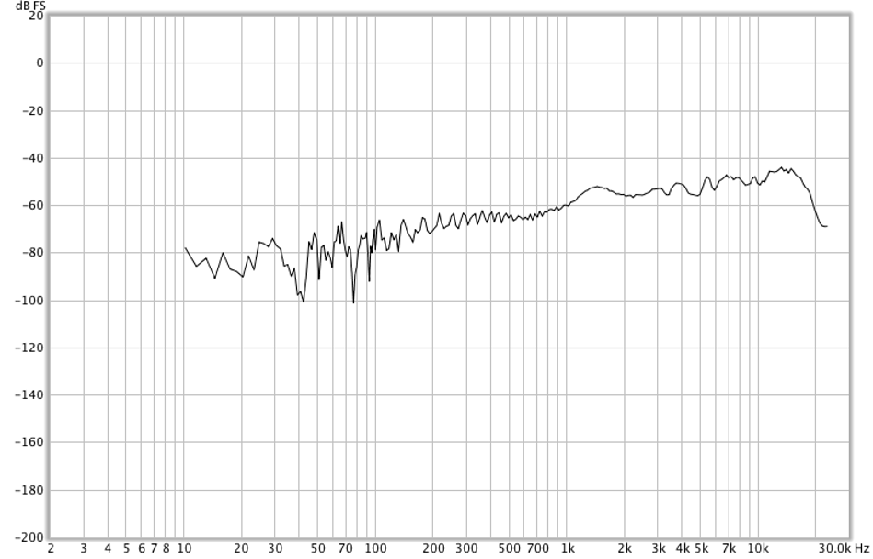
Test Results/whitenoise-event.png
