paulfaget/PlasmaArcSpeaker/Test Results/whitenoise-t-Shrunk.png

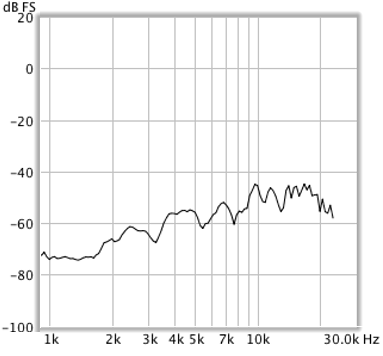
Test Results/whitenoise-t-Shrunk.png
