paulfaget/PlasmaArcSpeaker/Test Results/whitenoise-t.png

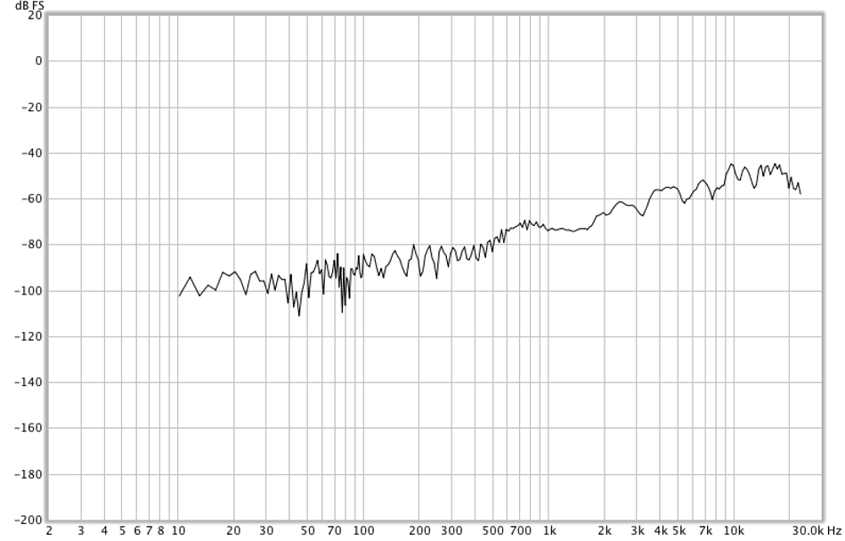
Test Results/whitenoise-t.png
