paulfaget/PlasmaArcSpeaker/Mechanical/Full Assembly.pdf

ITEM NO. | PART NUMBER | QTY.
1 | Gear Housing 1 | 1
2 | Spur Gear | 1
3 | Rack spur Gear | 2
4 | knob | 1
5 | Gear Housing 2 | 1
6 | Electrode Arm | 2
7 | Cone | 1
8 | Front cover | 1
9 | Back cover | 1
10 | Top Bottom | 2
11 | Side | 2
12 | input | 1
13 | Electrode | 2
14 | Bolt | 2
15 | Washer | 8
16 | Nut | 4

## Phillip Shepard & Shawn Day Plasma Arc Speaker ME497 Capstone

THE INFORMATION CONTAINED IN THIS DRAWING IS THE SOLE PROPERTY OF PAS. ANY REPRODUCTION IN PART OR AS A WHOLE WITHOUT THE WRITTEN PERMISSION OF PAS IS PROHIBITED.

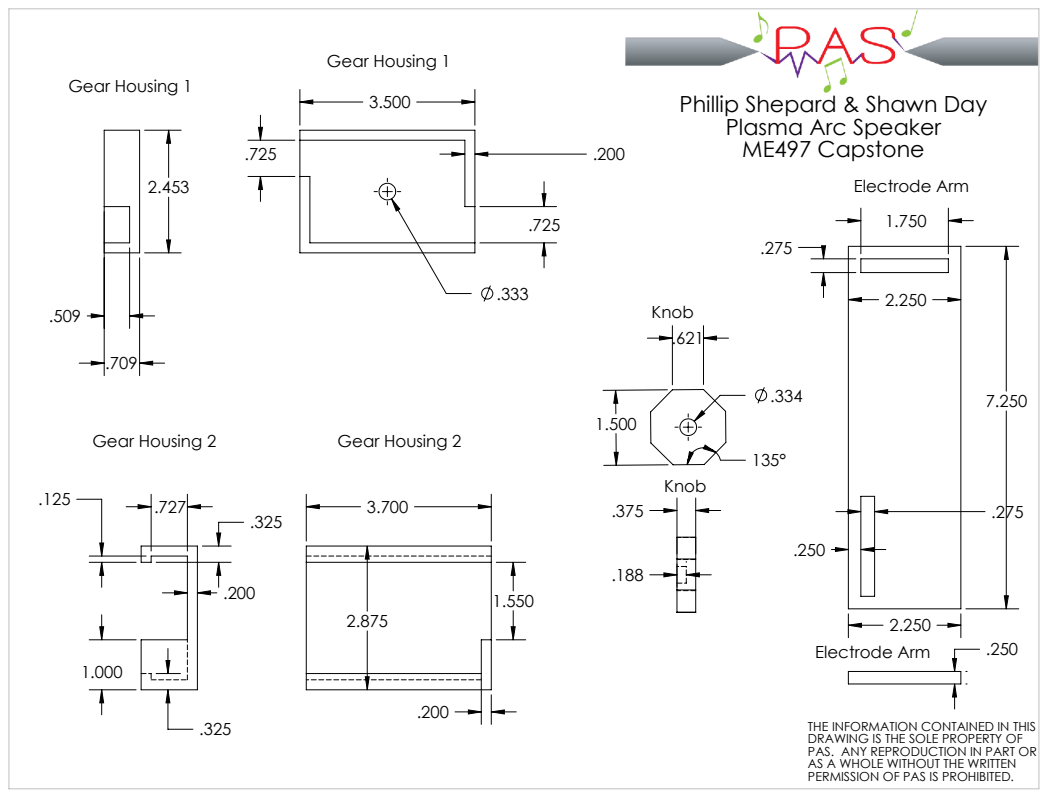
[picture p62: page 2]
Gear Housing 1; Gear Housing 2; Electrode Arm

Phillip Shepard & Shawn Day
Plasma Arc Speaker
ME497 Capstone

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

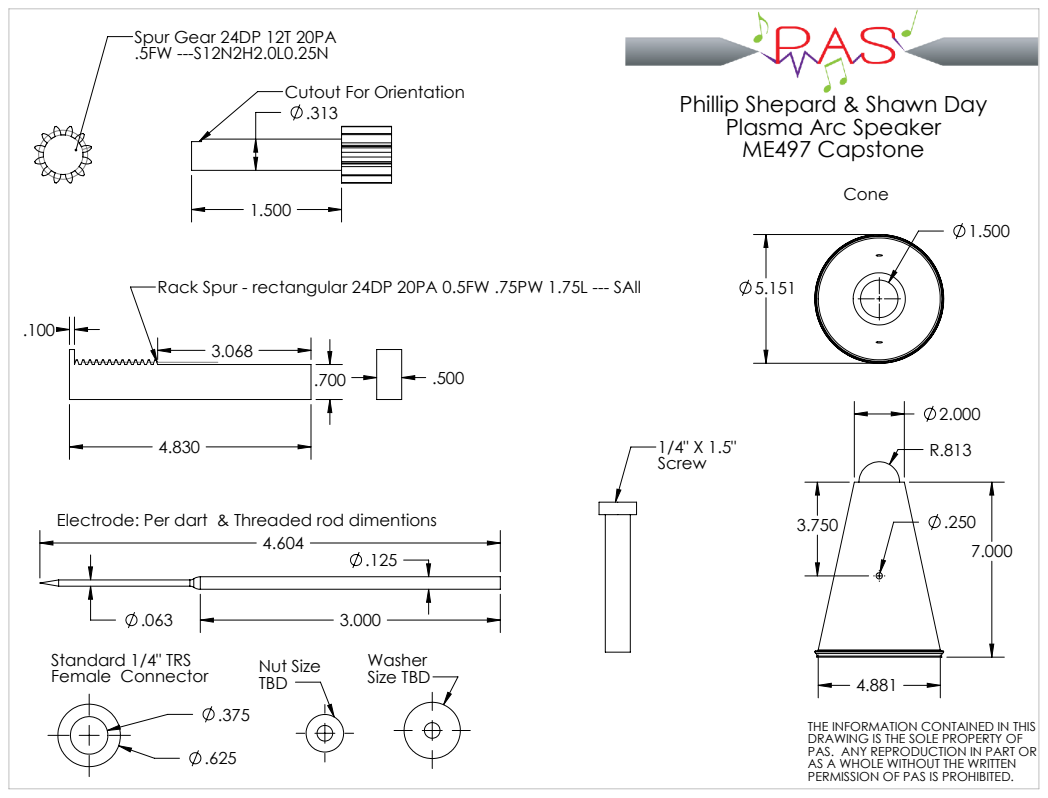
[picture p63: page 3]
Spur Gear 24DP 12T 20PA .5FW ---S12N2H2.0L0.25N; Nut Size; Size TBD; Standard 1/4" TRS Female Connector

Cutout For Orientation

Phillip Shepard & Shawn Day
Plasma Arc Speaker
ME497 Capstone

Rack Spur - rectangular 24DP 20PA 0.5FW .75PW 1.75L --- SAll

Electrode: Per dart & Threaded rod dimentions

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

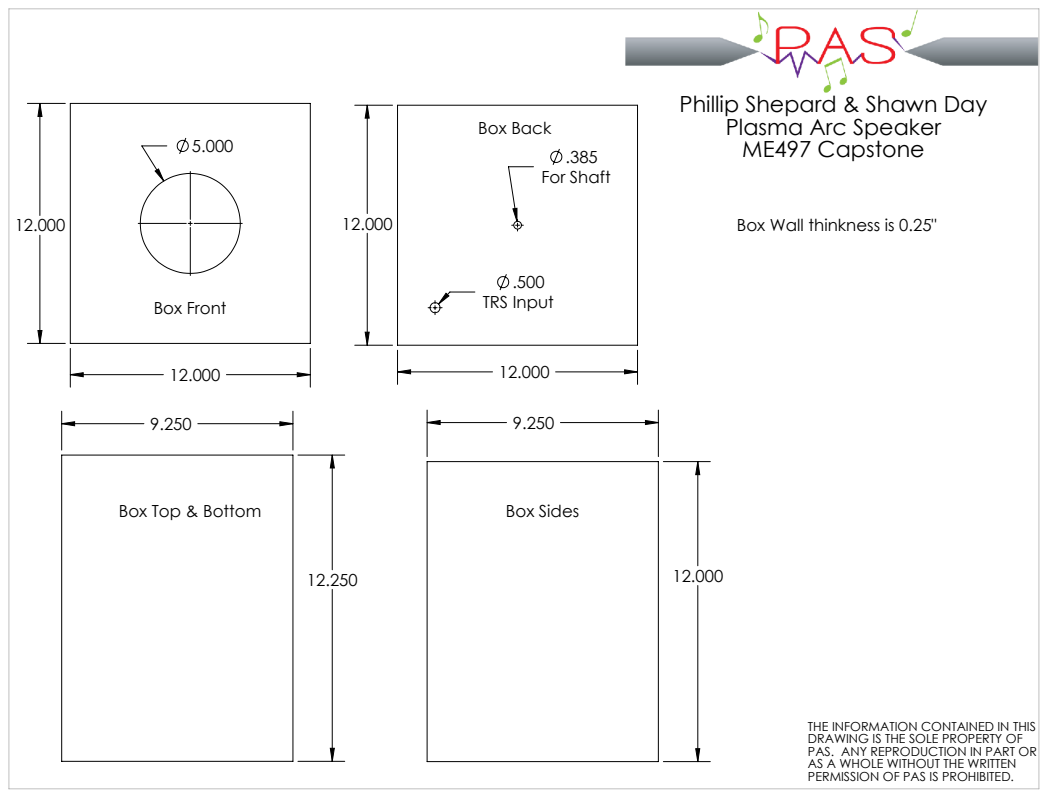
[picture p64: page 4]
TRS Input; For Shaft; Box Front; Box Back; Box Sides

Phillip Shepard & Shawn Day
Plasma Arc Speaker
ME497 Capstone

Box Wall thinkness is 0.25"

Box Top & Bottom

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
