paulfaget/PlasmaArcSpeaker/Schematics and Drawings/Mechanical/Gear Assembly.PDF

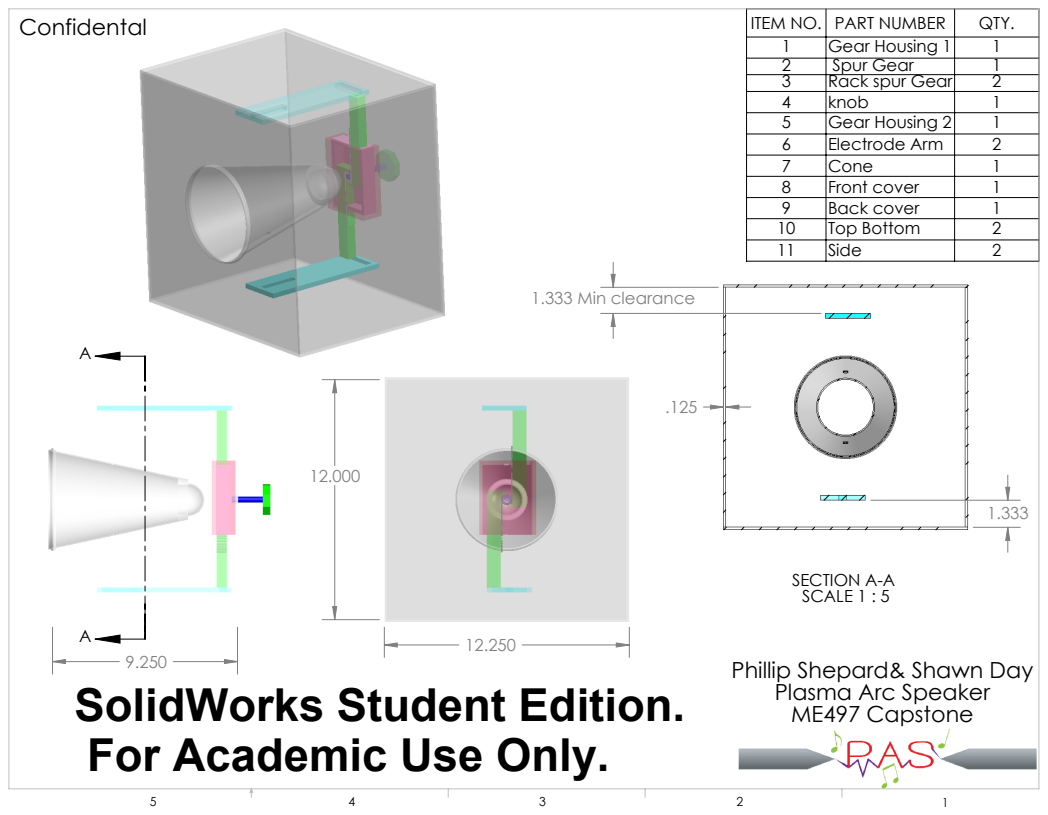
[picture p65: page 1]
1.333 Min clearance; SECTION A-A SCALE 1 : 5; Confidental; ITEM NO.; PART NUMBER; QTY.

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

SolidWorks Student Edition.
For Academic Use Only.

Phillip Shepard& Shawn Day
Plasma Arc Speaker
ME497 Capstone
